Gabriel-Freitas-S/braco-robortico/impressao/pecas_fatiadas/README.md

# 🖨️ Arquivos Fatiados — Peças Individuais (Bambu Lab A1)

Contém os `.3mf` prontos para enviar diretamente à impressora Bambu Lab A1 —
29 peças (27 numeradas + H1 e H2).
Cada arquivo foi fatiado com:

- **Perfil:** `0.20mm Standard @BBL A1`
- **Bico:** 0.4 mm · **Material:** Bambu PLA Basic Preto (`#22262C`) · **Prato:** Textured PEI

> Os STLs originais (com numeração em relevo baixo) estão em `impressao/pecas/`.
>
> **Mudanças desta revisão:** a peça **26 (engrenagem) saiu do projeto**; a **04**
> usa a geometria de encaixe de 10 mm e a **12** é a Turret V7 Redonda (86 mm).
> As hastes `olhal_v4` e `curta` são as peças novas da garra.

## Tempos e Filamento por Peça

| Peça | Nome | Tempo | Filamento |
|---|---|---|---|
| 01 | Base_Chassi_Inferior | 42 min | 25.1 g |
| 02 | Braco_Principal_Esquerdo | 15 min | 2.8 g |
| 03 | Tirante_Paralelogramo_Longo | 16 min | 3.1 g |
| 04 | Tirante_Paralelogramo_Medio | 12 min | 2.4 g |
| 05 | Haste_Acionamento_Servo_Braco | 11 min | 1.9 g |
| 06 | Antebraco_Esquerdo | 11 min | 1.9 g |
| 07 | Braco_Principal_Direito | 12 min | 2.1 g |
| 08 | Antebraco_Direito | 11 min | 1.9 g |
| 09 | Torre_Suporte_Servo_Direita | 22 min | 6.5 g |
| 10 | Balancim_Triangular_Articulador | 14 min | 3.0 g |
| 11 | Torre_Suporte_Servo_Esquerda | 21 min | 5.8 g |
| 12 | Mesa_Giratoria_Turntable | 30 min | 15.2 g |
| 13 | Tirante_Superior_Garra | 11 min | 1.2 g |
| 14 | Separador_Espacador_Central_Base | 14 min | 2.8 g |
| 15 | Suporte_Cabeca_Garra | 11 min | 1.8 g |
| 16 | Berco_Servo_Rotacao_Base | 18 min | 5.6 g |
| 17 | Travessa_Reforco_Base_Frontal | 13 min | 2.3 g |
| 18 | Travessa_Reforco_Base_Traseira | 13 min | 2.1 g |
| 19 | Garra_Base_Suporte_Fixo | 13 min | 2.2 g |
| 20 | Garra_Dedo_Movel_Direito | 11 min | 1.3 g |
| 21 | Garra_Dedo_Movel_Esquerdo | 11 min | 1.3 g |
| 22 | Biela_Conexao_Horn_Direito | 12 min | 2.0 g |
| 23 | Biela_Conexao_Horn_Esquerdo | 12 min | 2.0 g |
| 24 | Suporte_Encaixe_Servo_Garra | 11 min | 1.4 g |
| 25 | Trava_Horn_Servo_Base | 10 min | 1.3 g |
| 27 | Guia_Articulacao_Garra | 9 min | 0.8 g |
| 28 | Biela_Articulacao_Curta | 8 min | 0.4 g |
| — | haste_articulacao_olhal_v4 | 9 min | 1.0 g |
| — | haste_articulacao_curta | 8 min | 0.6 g |
| **TOTAL** | **29 arquivos** | **7h 07min** | **101.7 g** |

*Estimativas geradas por Bambu Studio CLI oficial com perfil padrão 0.20 mm e Bambu PLA Basic Preto.*
