Gabriel-Freitas-S/braco-robortico/impressao/pratos/fatiados/README.md

# 🖨️ Pratos de Impressão Fatiados — Bambu Lab A1 (100% Filamento Preto)

Contém os 2 pratos `.3mf` prontos para enviar à Bambu Lab A1, configurados
exclusivamente para **Bambu PLA Basic Preto** (monocromático / slot único).
Fatiados com Bambu Studio 02.09.01.70 · `0.20mm Standard @BBL A1` · PLA ·
0.4 mm nozzle · Textured PEI Plate.

> Os pratos de projeto (sem gcode) ficam em `impressao/pratos/`.
>
> **Mudanças desta revisão:** peça **26 removida** (engrenagem), **04** com
> encaixe de 10 mm, **12** Turret V7 Redonda (86 mm) e as peças **H1/H2**
> incluídas no Prato 2.

---

## Prato 1 — Chassi, Base & Torres

**Arquivo:** `Prato_1_Chassi_Estrutura_Bambu_A1_sliced.3mf`

| Peça | Nome |
|---|---|
| 01 | Base_Chassi_Inferior |
| 09 | Torre_Suporte_Servo_Direita |
| 11 | Torre_Suporte_Servo_Esquerda |
| 12 | Mesa_Giratoria_Turntable (V7 Redonda) |
| 14 | Separador_Espacador_Central_Base |
| 16 | Berco_Servo_Rotacao_Base |
| 17 | Travessa_Reforco_Base_Frontal |
| 18 | Travessa_Reforco_Base_Traseira |
| 25 | Trava_Horn_Servo_Base |

- ⏱️ **Tempo de Impressão:** ~2h 10min
- 🧵 **Filamento:** 66.3 g Bambu PLA Basic Preto (#22262C)
- 📐 **Altura de Camada:** 0.20 mm Standard

---

## Prato 2 — Braço, Bielas & Garra

**Arquivo:** `Prato_2_Mecanica_Garra_Bambu_A1_sliced.3mf`

| Peça | Nome |
|---|---|
| 02 | Braco_Principal_Esquerdo |
| 03 | Tirante_Paralelogramo_Longo |
| 04 | Tirante_Paralelogramo_Medio (encaixe 10 mm) |
| 05 | Haste_Acionamento_Servo_Braco |
| 06 | Antebraco_Esquerdo |
| 07 | Braco_Principal_Direito |
| 08 | Antebraco_Direito |
| 10 | Balancim_Triangular_Articulador |
| 13 | Tirante_Superior_Garra |
| 15 | Suporte_Cabeca_Garra |
| 19 | Garra_Base_Suporte_Fixo |
| 20 | Garra_Dedo_Movel_Direito |
| 21 | Garra_Dedo_Movel_Esquerdo |
| 22 | Biela_Conexao_Horn_Direito |
| 23 | Biela_Conexao_Horn_Esquerdo |
| 24 | Suporte_Encaixe_Servo_Garra |
| 27 | Guia_Articulacao_Garra |
| 28 | Biela_Articulacao_Curta |
| — | haste_articulacao_olhal_v4 |
| — | haste_articulacao_curta |

- ⏱️ **Tempo de Impressão:** ~2h 03min
- 🧵 **Filamento:** 36.0 g Bambu PLA Basic Preto (#22262C)
- 📐 **Altura de Camada:** 0.20 mm Standard

---

## Resumo Geral

| Prato | Peças | Tempo Estimado | Filamento | Status |
|---|---|---|---|---|
| **Prato 1 (Chassi/Base)** | 9 | 2h 10min | 66.3 g | ✅ Pronto |
| **Prato 2 (Braço/Garra)** | 20 | 2h 03min | 36.0 g | ✅ Pronto |
| **TOTAL** | **29** | **~4h 13min** | **~102.3 g PLA Preto** | 1 carretel de 1 kg basta |

> 💡 **Nota:** com o projeto 100% em filamento preto não há troca de filamento
> nem torre de purga.
>
> ⚠️ **Calibração:** habilite a *Flow Dynamics Calibration* antes do Prato 2
> para as tolerâncias dos dedos 20/21 e da guia 27.
