Gabriel-Freitas-S/braco-robortico/app/README.md

# RoboControl — controle e gravação do braço 4-DOF

App desktop (Rust + egui) que conversa com o firmware pela USB em 115200 baud.
O firmware continua dono do movimento: aqui só **propomos alvos**. A rampa, os
limites mecânicos e o hold ficam na placa, então um comando perdido no USB não
vira tranco.

## Requisitos

| | |
|---|---|
| **Todos** | Rust stable + `cargo`; Arduino Uno + cabo USB |
| **Linux** | usuário no grupo `dialout` (Arch: `uucp`) + libs de build |
| **Windows** | Rust MSVC + *Desktop development with C++*; driver CH340 em clones |
| **macOS** | Xcode Command Line Tools |

O `install.sh` é só Linux; nos outros sistemas use `cargo run --release`.

## Rodar

### Linux

```bash
cd app && ./install.sh   # opcional: instala no menu
# ou: cargo run --release
```

Instala sem root: binário em `~/.local/bin/robocontrol`, ícone e entrada
**RoboControl** no menu de aplicativos. Movimentos em
`~/.local/share/robocontrol/movimentos/` (ou `$XDG_DATA_HOME/...`).

### macOS

```bash
cd app && cargo run --release
```

Movimentos em `~/.local/share/robocontrol/movimentos/`.

### Windows (PowerShell)

```powershell
cd app
cargo run --release
# ou: cargo build --release; .\target\release\robocontrol.exe
```

Movimentos em `%APPDATA%\robocontrol\movimentos`.

Depois: escolher a porta (Linux `/dev/ttyACM0`; macOS `/dev/cu.usbmodem*`;
Windows `COM3`) → **Conectar** → **Assumir controle (PC)**.

A tela mostra **dois pads de toque**, no mesmo layout da bancada:

| Pad | Eixo X | Eixo Y |
|---|---|---|
| Esquerdo | Base | Cotovelo |
| Direito | Garra | Ombro |

Arrastar move como alavanca; **soltar o dedo centraliza = segurar a posição**.

## Modo híbrido (a regra de segurança)

| Situação | O que acontece |
|---|---|
| Joystick na mão | o firmware ignora o PC |
| **Assumir controle (PC)** | firmware adota os alvos partindo do ângulo atual |
| **Joystick com o PC no controle** | fica **travado**: mexer a alavanca não interfere (v1.3.3) |
| **Devolver ao joystick** / STOP | única forma de pegar o controle de volta na mão |
| 500 ms sem alvos (app travou, cabo caiu) | segura a posição atual e devolve ao joystick |
| **STOP** | `#H`: segura as juntas agora |
| **Travar garra** | `#L1`: mantém pressão contínua no objeto e bloqueia abertura |
| **Liberar garra** | `#L0`: a garra volta a abrir pelo pad |

A trava é a mesma do botão físico D4 — um só estado (`garraTravada`) no firmware,
então o botão da bancada e o botão do app nunca discordam. Com a trava ativa a
garra **só aperta**: nem o pad, nem o replay (`#P`) conseguem abrir.

## Gravação

- **Gravar** captura a pose a 20 Hz — inclusive quando você está movendo no
  joystick (é "ensinar fazendo").
- **Parar e salvar** grava em `~/.local/share/robocontrol/movimentos/<nome>.json` (Windows: `%APPDATA%\robocontrol\movimentos`).
- **▶** carrega um movimento; **✕** exclui (com confirmação na própria linha); **Reproduzir** manda os alvos interpolados.
  Tocar o joystick cancela o replay (o firmware sai do modo PC).

## Protocolo (firmware v1.3+)

```
#P<b>;<o>;<c>;<g>   alvos em graus (replay / ajuste fino)
#V<lx>;<ly>;<rx>;<ry>  sticks virtuais -100..100 (20 Hz; reenviar é o heartbeat)
#M                  assume o controle
#J                  devolve ao joystick
#H                  segura agora
#L0 / #L1           libera / trava a pressão da garra
#S                  status  →  S<b>;<o>;<c>;<g>;<modo>;<trava>
#B                  diagnóstico → B<versão>;boots=N;limb=min;max;limo=...;limc=...;limg=...
```

Testar sem o app:

```bash
# Linux
stty -F /dev/ttyACM0 115200 raw -echo
printf '#B\n' > /dev/ttyACM0 && cat /dev/ttyACM0
```

## Diagnóstico de alimentação

O app mostra `boots=N` (contador de resets em `.noinit`). **Se esse número subir
enquanto o braço se move, a placa reiniciou** — é a alimentação, não o servo.
O aviso aparece em vermelho na barra superior.

## Estrutura

- `src/protocol.rs` — codificação/decodificação das linhas (testado)
- `src/link.rs` — porta serial: leitura em thread, escrita síncrona
- `src/motion.rs` — gravação, interpolação do replay, JSON (testado)
- `src/main.rs` — UI egui (pads de toque, gravação, replay)

## Documentação

O código usa rustdoc (`//!` nos módulos, `///` nos itens). A versão navegável
fica em [`docs/rust/`](../docs/rust/robocontrol/index.html) e é publicada em
<https://gabriel-freitas-s.github.io/braco-robortico/rust/robocontrol/index.html>.
Para regenerar depois de mudar o código:

```bash
cargo doc --no-deps --document-private-items
rsync -a --delete --exclude='.lock' --exclude='/index.html' target/doc/ ../docs/rust/
```

`--document-private-items` é obrigatório: o crate é binário, então sem ele o
HTML sai quase vazio. O `--exclude='/index.html'` preserva o redirecionamento
de `docs/rust/` para `robocontrol/`.

## Sentido dos eixos

`#V` positivo em X do pad esquerdo **diminui** o ângulo da base; Y para cima do
pad esquerdo **aumenta** o cotovelo; X do pad direito **abre** a garra; Y para
cima **aumenta** o ombro. Se algum ficar invertido na mão, é só trocar o sinal
na montagem de `cmd_sticks` em `tick()`.
