Gabriel-Freitas-S/braco-robortico/.opencode/command/doctor.md

---
description: Verifica a configuração local de fabricação e relata dependências ausentes.
agent: build
---

No diretório raiz do projeto, execute `python .agents/skills/bambu-studio-ai/scripts/doctor.py`. Relate o que está ausente ou precisa de configuração, incluindo Bambu Studio e configuração de impressoras.

Contexto: $ARGUMENTS
