Gabriel-Freitas-S/braco-robortico/bambu-output/braco_montado_numerado_preview.png

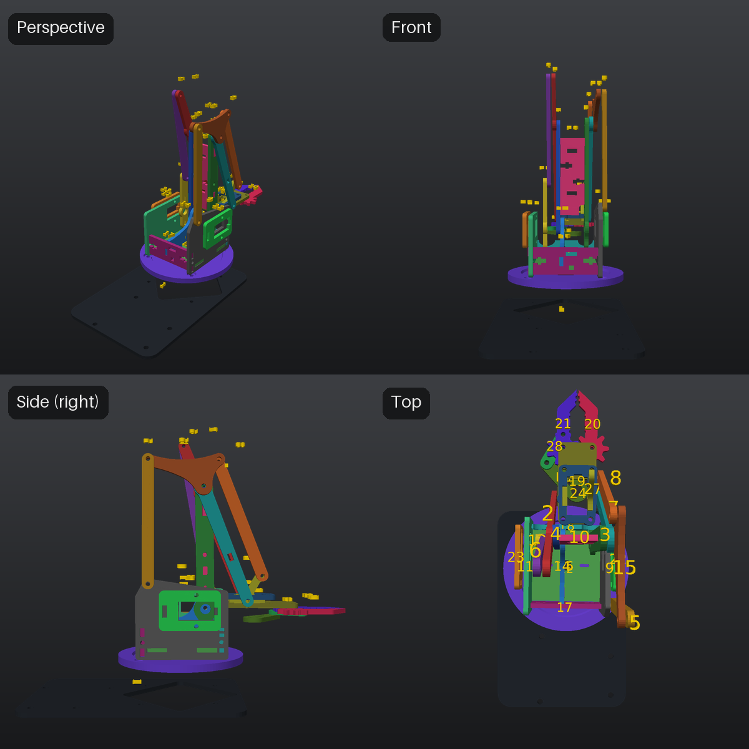
bambu-output/braco_montado_numerado_preview.png
