Gabriel-Freitas-S/braco-robortico/cad-output/01_Base_Chassi_Inferior_preview.png

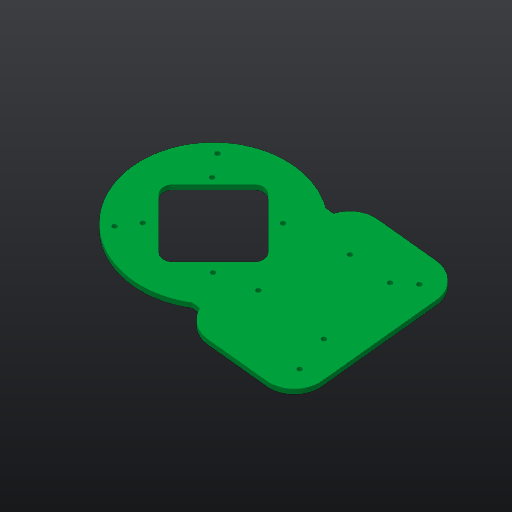
cad-output/01_Base_Chassi_Inferior_preview.png
