Gabriel-Freitas-S/braco-robortico/cad-output/04_Tirante_Paralelogramo_Medio_preview.png

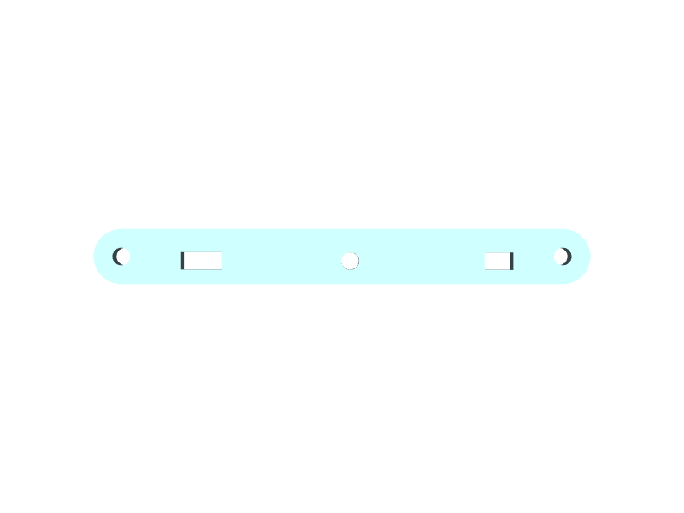
cad-output/04_Tirante_Paralelogramo_Medio_preview.png
