Gabriel-Freitas-S/braco-robortico/cad-output/hastes_articulacao_iso.png

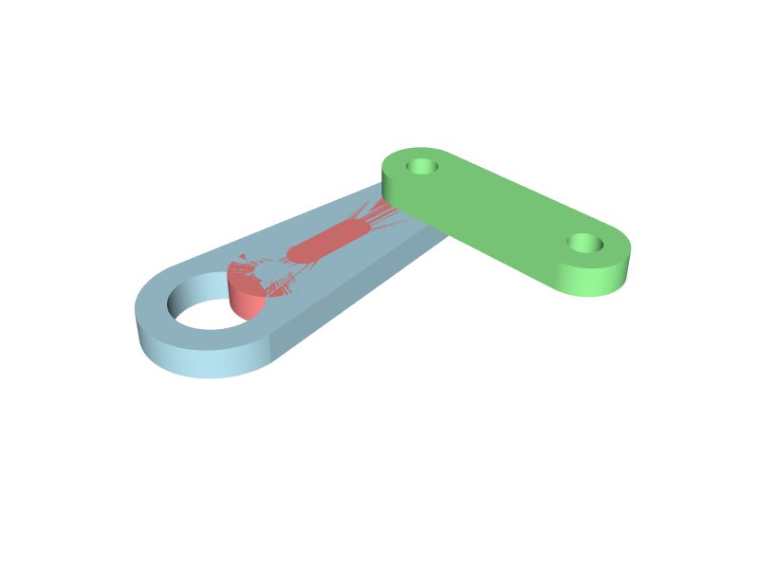
cad-output/hastes_articulacao_iso.png
