Gabriel-Freitas-S/braco-robortico/docs/assets/renders/base_01_original_mdf_3d.png

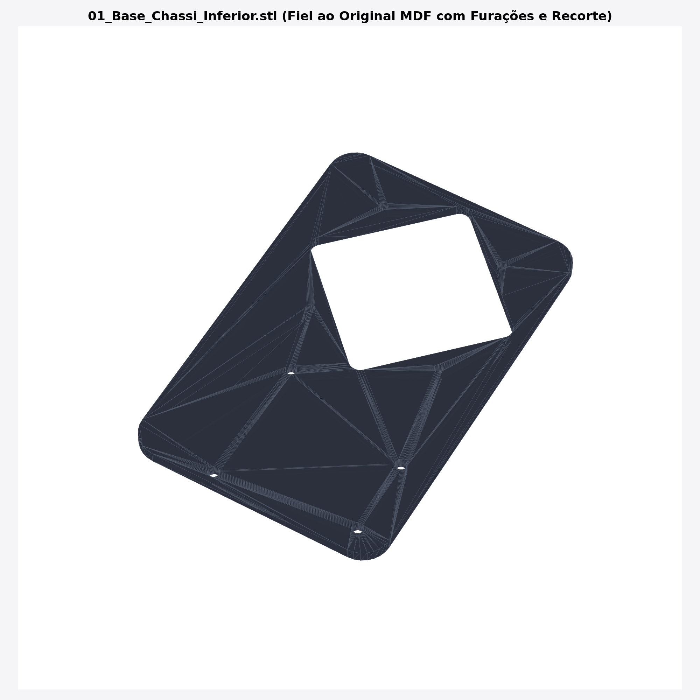
docs/assets/renders/base_01_original_mdf_3d.png
