Gabriel-Freitas-S/braco-robortico/docs/assets/renders/base_01_rectangular_preview.png

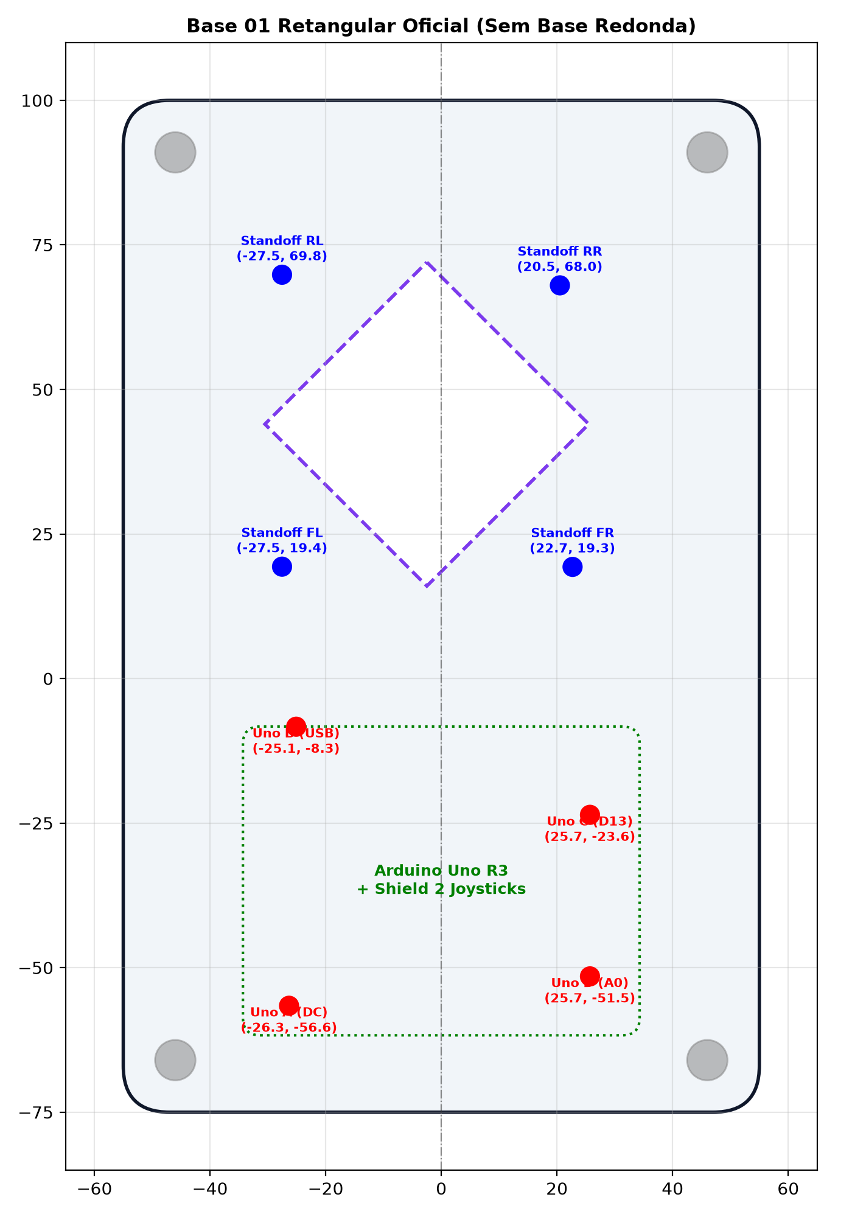
docs/assets/renders/base_01_rectangular_preview.png
