Gabriel-Freitas-S/braco-robortico/docs/assets/renders/base_01_symmetric_preview.png

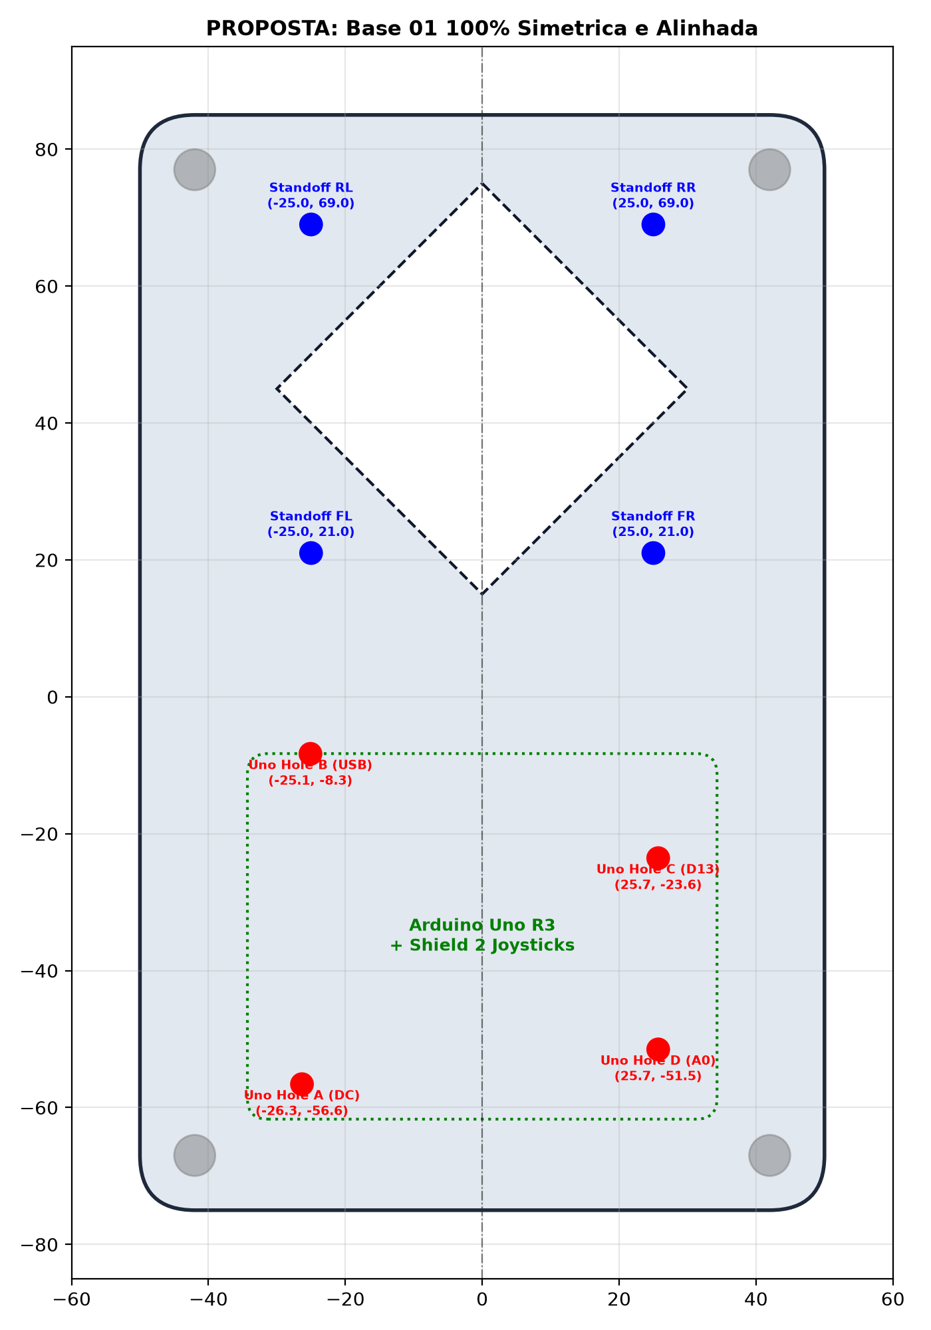
docs/assets/renders/base_01_symmetric_preview.png
