Gabriel-Freitas-S/braco-robortico/docs/assets/renders/base_plate_comparison.png

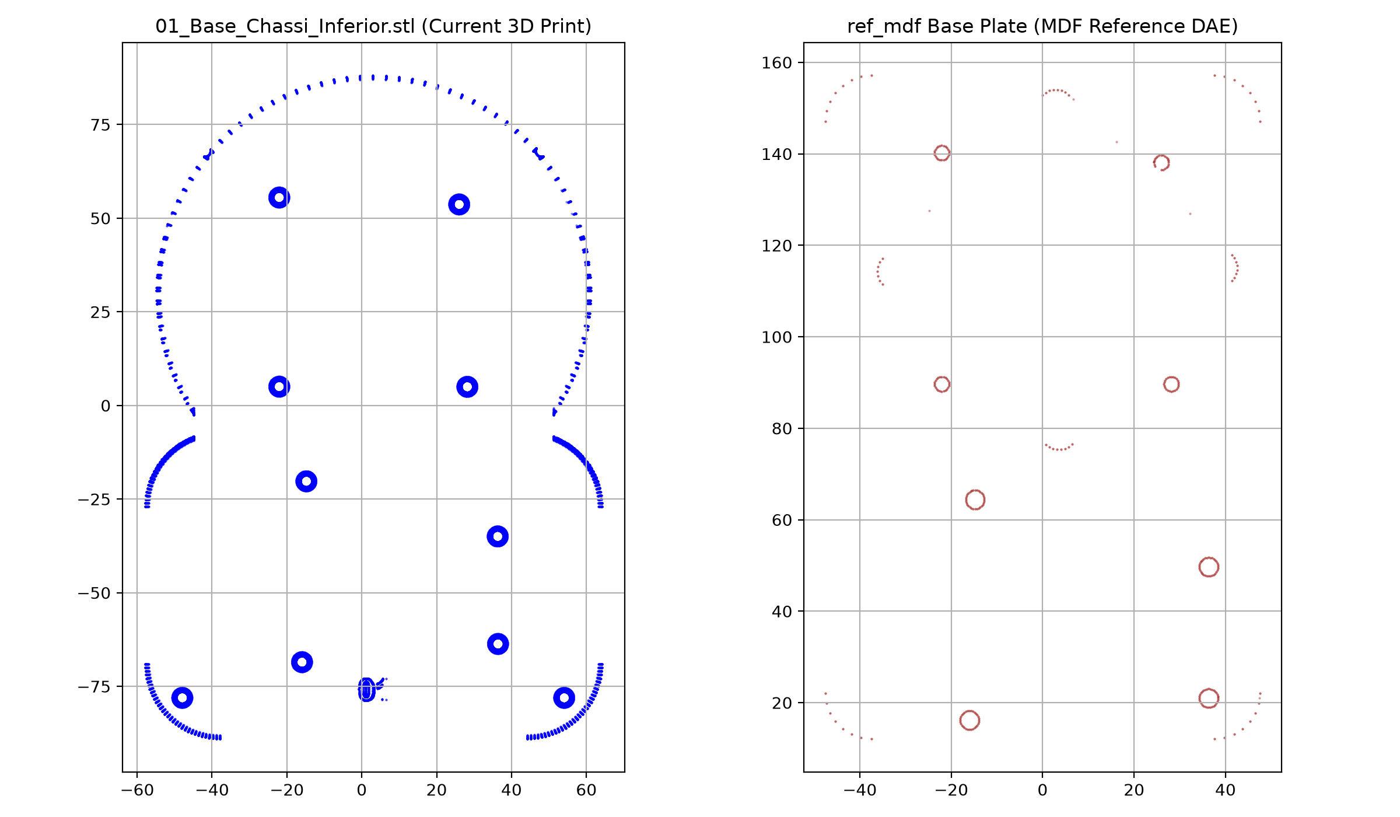
docs/assets/renders/base_plate_comparison.png
