Gabriel-Freitas-S/braco-robortico/docs/assets/renders/base_servo_underside_check.png

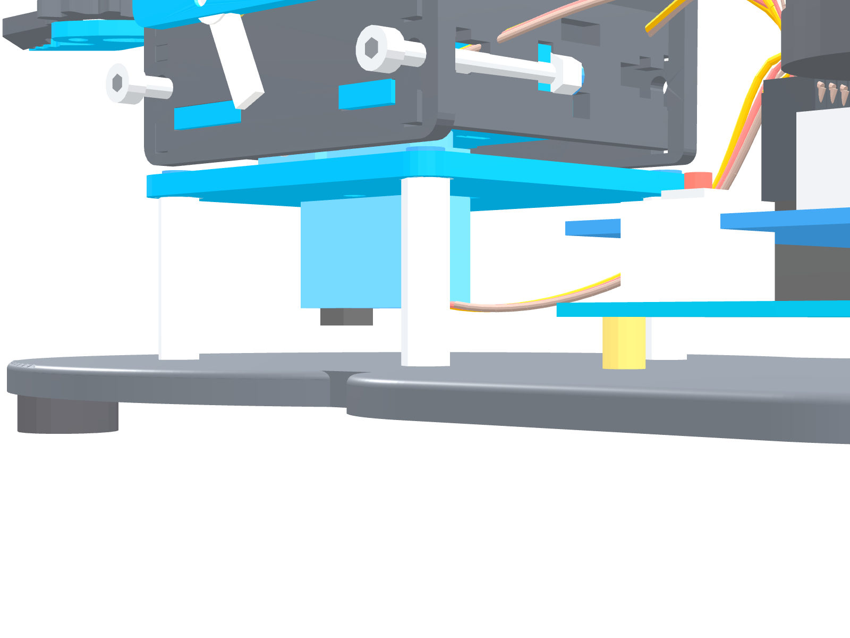
docs/assets/renders/base_servo_underside_check.png
