Gabriel-Freitas-S/braco-robortico/docs/assets/renders/braco_capa_lateral_dinamica.png

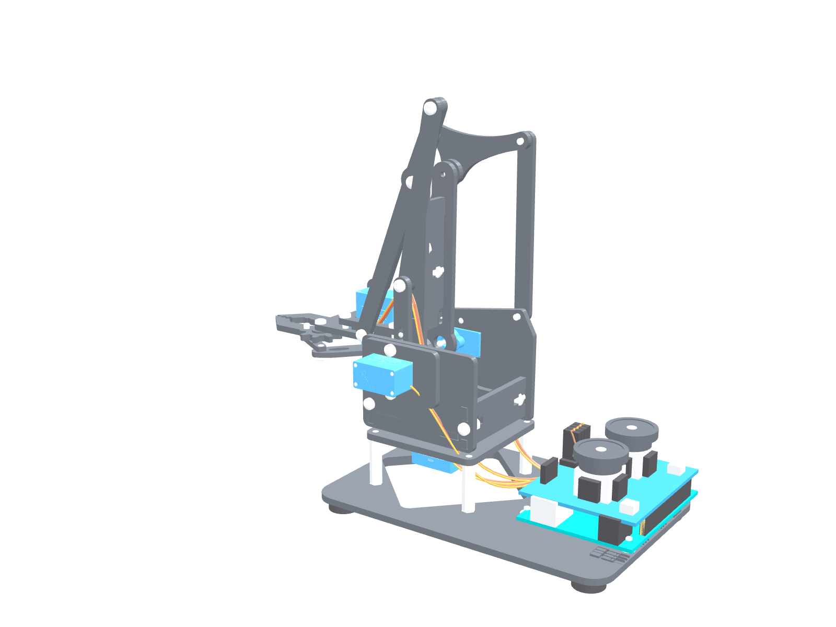
docs/assets/renders/braco_capa_lateral_dinamica.png
