Gabriel-Freitas-S/braco-robortico/docs/assets/renders/braco_colorido_iso.png

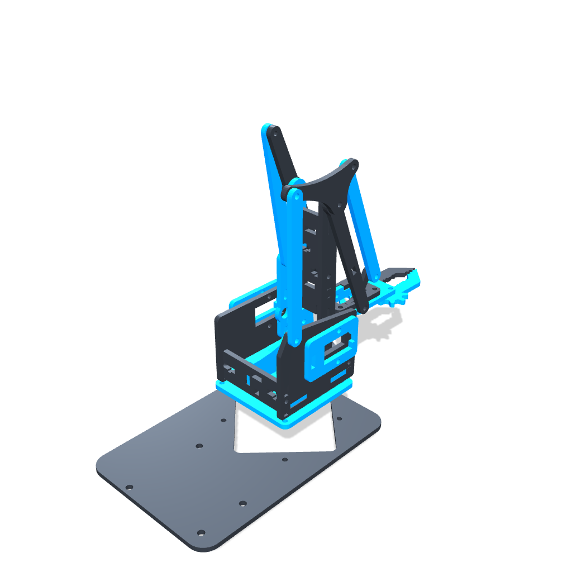
docs/assets/renders/braco_colorido_iso.png
