Gabriel-Freitas-S/braco-robortico/docs/assets/renders/braco_original_front.png

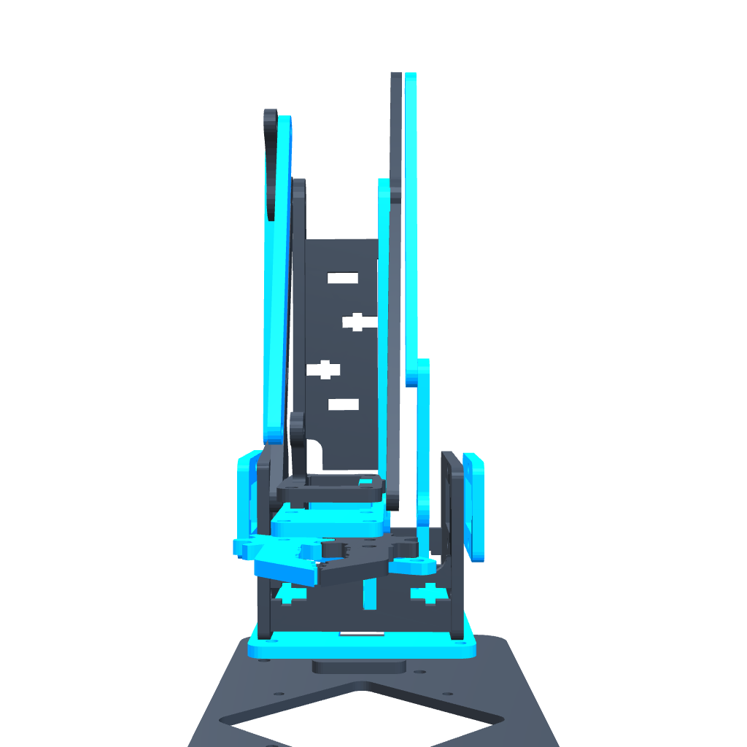
docs/assets/renders/braco_original_front.png
