Gabriel-Freitas-S/braco-robortico/docs/assets/renders/braco_original_iso.png

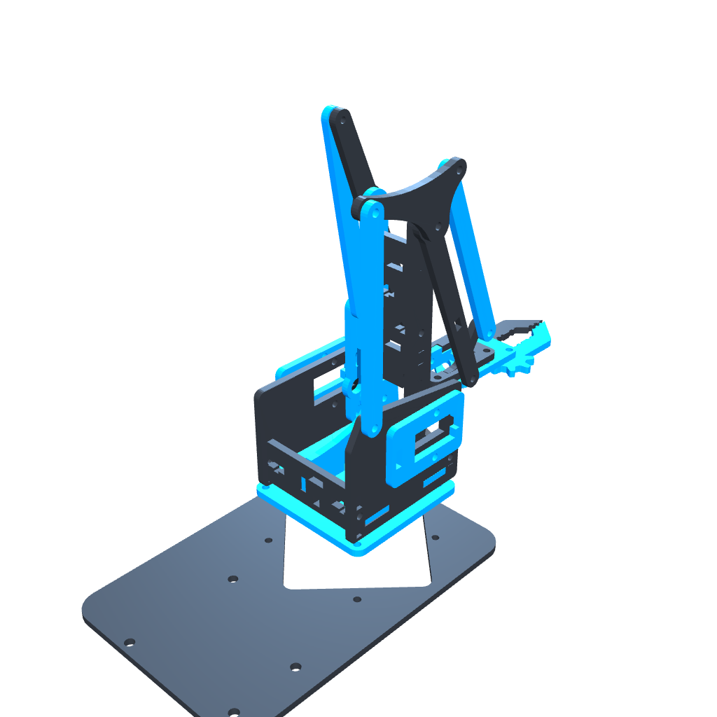
docs/assets/renders/braco_original_iso.png
