Gabriel-Freitas-S/braco-robortico/docs/assets/renders/braco_original_side.png

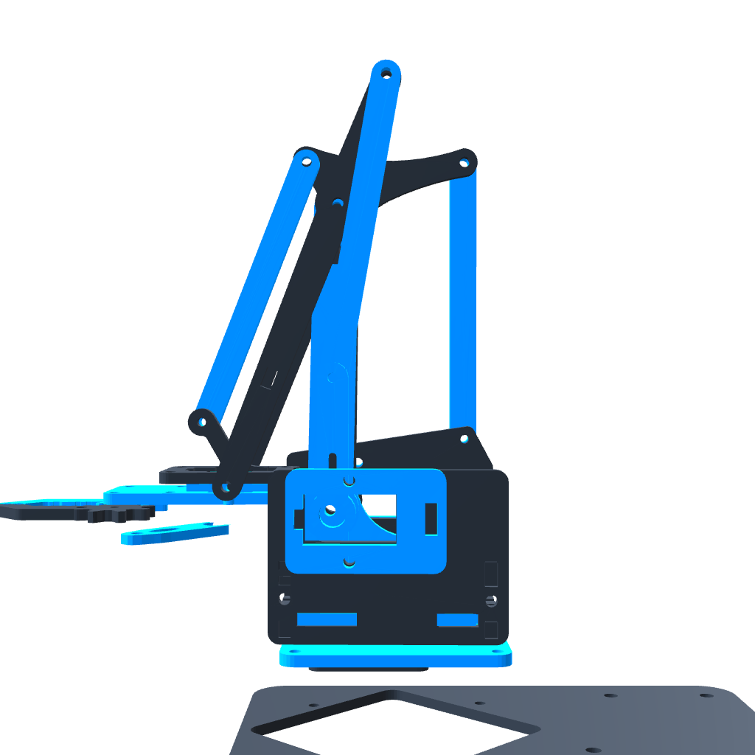
docs/assets/renders/braco_original_side.png
