Gabriel-Freitas-S/braco-robortico/docs/assets/renders/braco_original_top.png

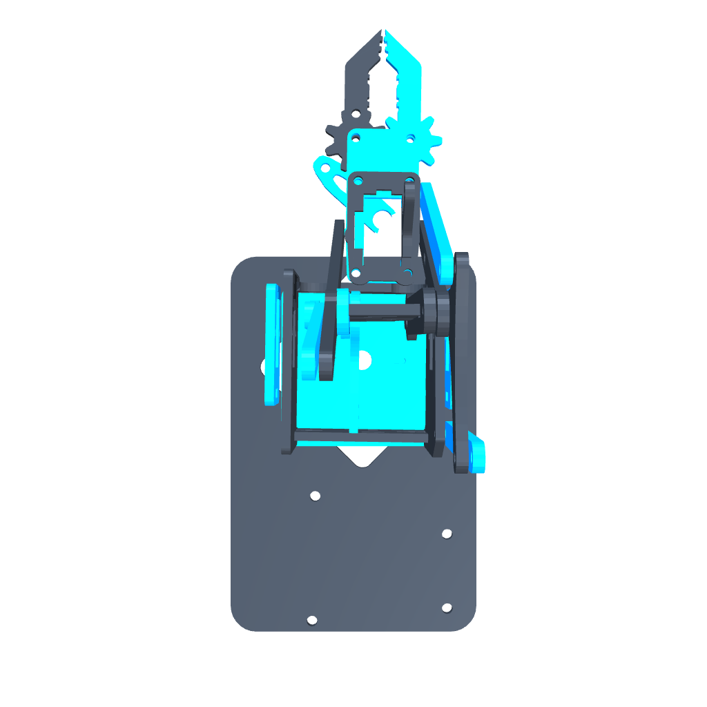
docs/assets/renders/braco_original_top.png
