Gabriel-Freitas-S/braco-robortico/docs/assets/renders/first_commit_base.png

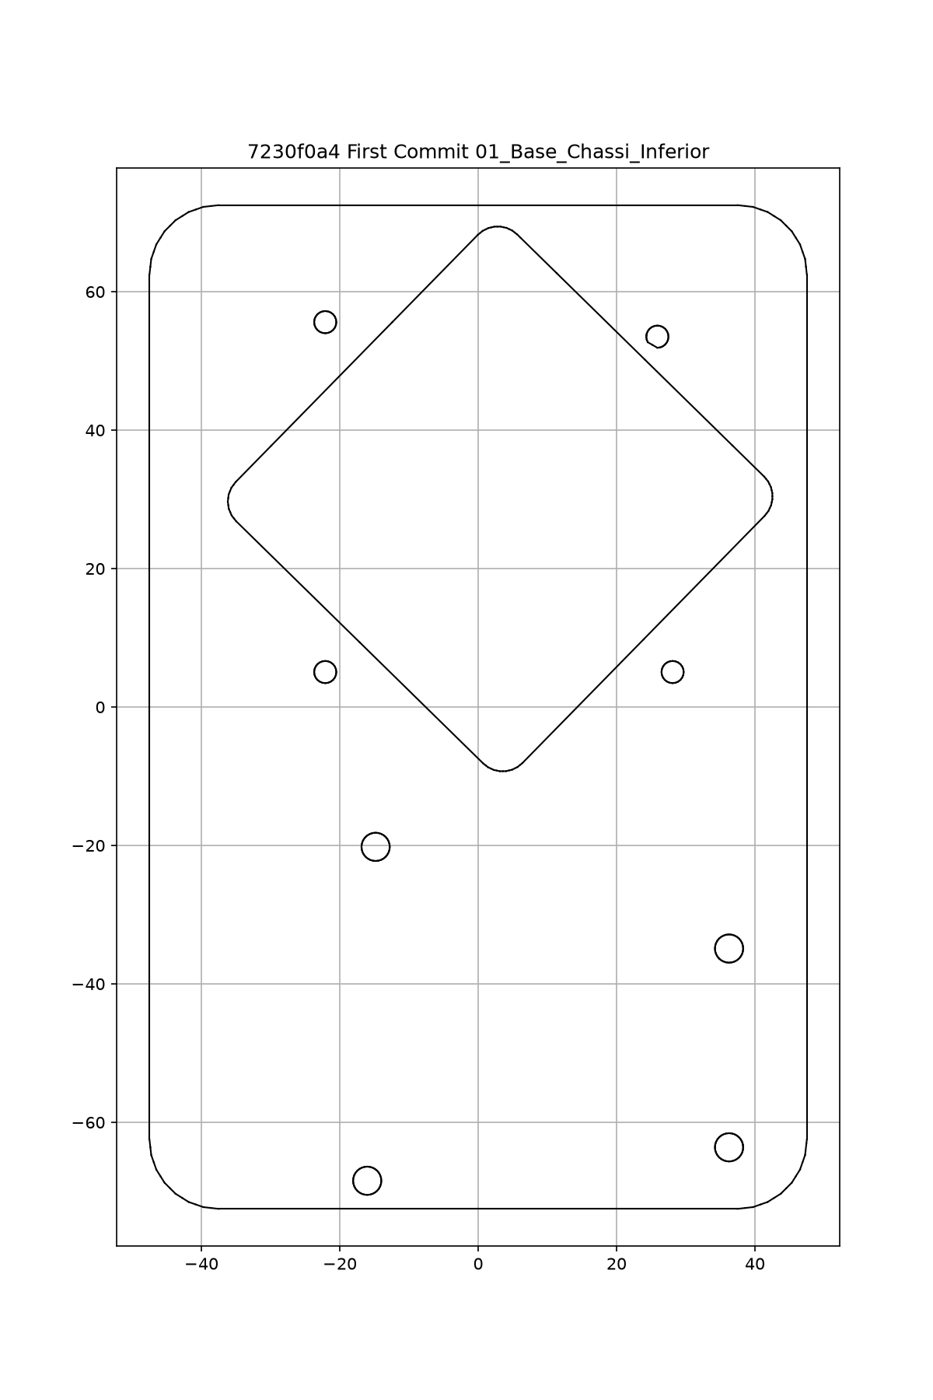
docs/assets/renders/first_commit_base.png
