Gabriel-Freitas-S/braco-robortico/docs/assets/renders/joystick_shield_arm_iso.png

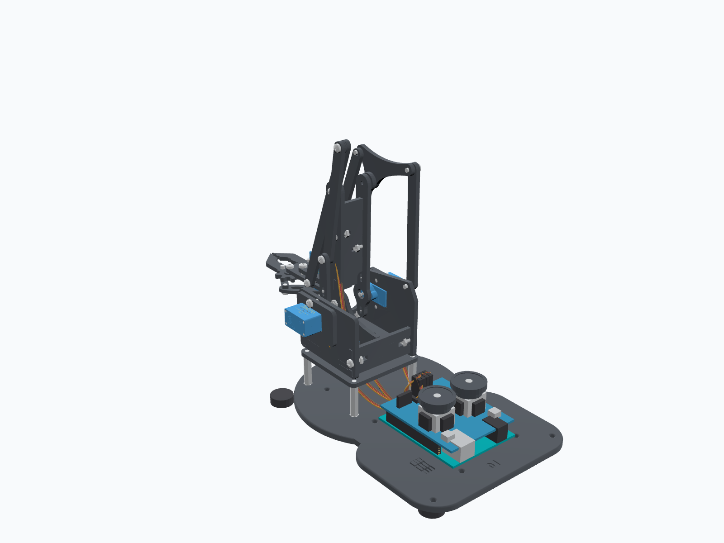
docs/assets/renders/joystick_shield_arm_iso.png
