Gabriel-Freitas-S/braco-robortico/docs/assets/renders/joystick_shield_zoom.png

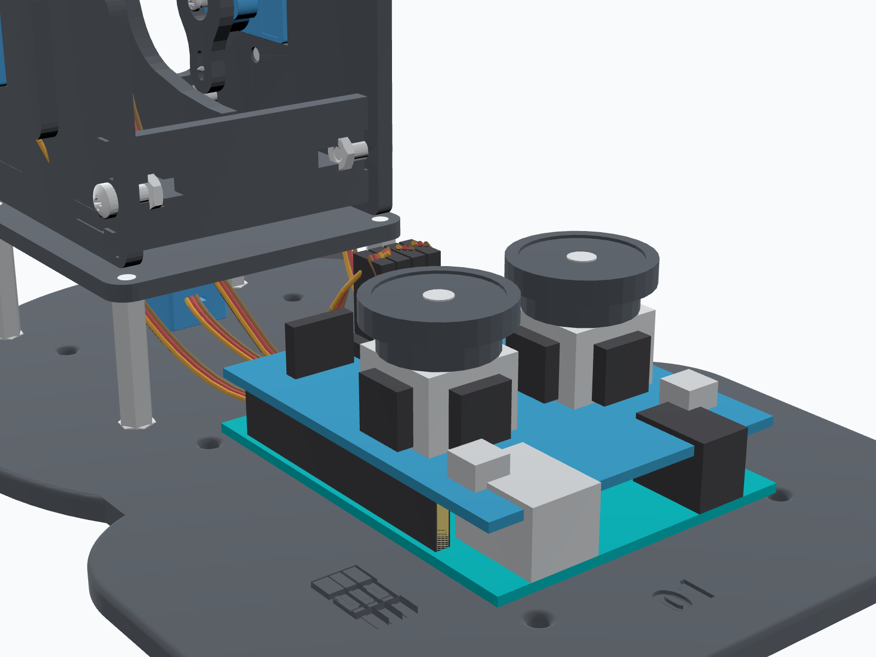
docs/assets/renders/joystick_shield_zoom.png
