Gabriel-Freitas-S/braco-robortico/docs/assets/renders/mdf_base_profile_detailed.png

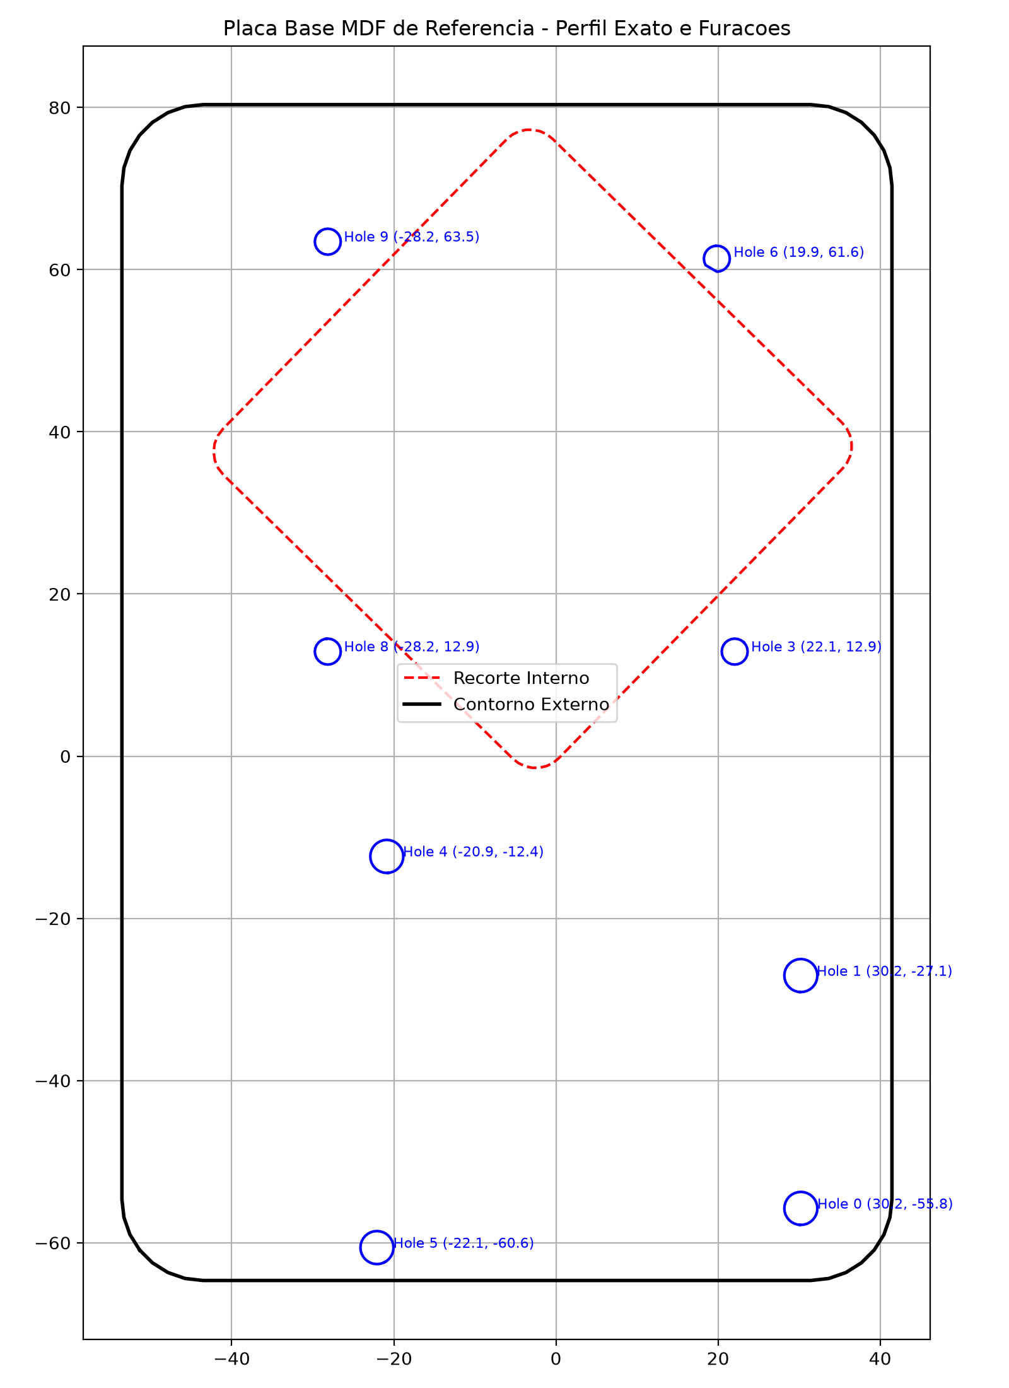
docs/assets/renders/mdf_base_profile_detailed.png
