Gabriel-Freitas-S/braco-robortico/docs/assets/renders/mesa_bambu_knolled.png

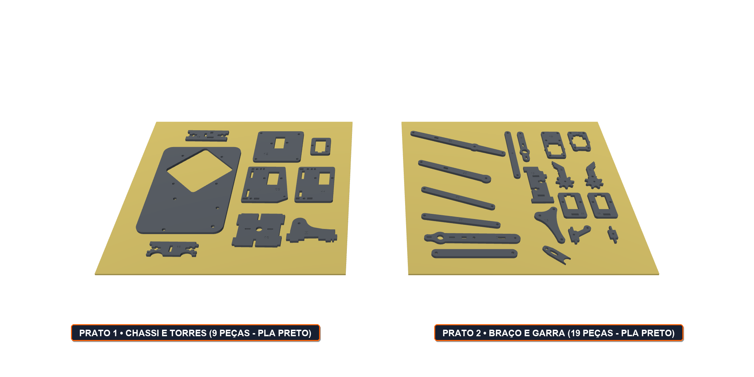
docs/assets/renders/mesa_bambu_knolled.png
