Gabriel-Freitas-S/braco-robortico/docs/assets/renders/mesa_bambu_knolled_raw.png

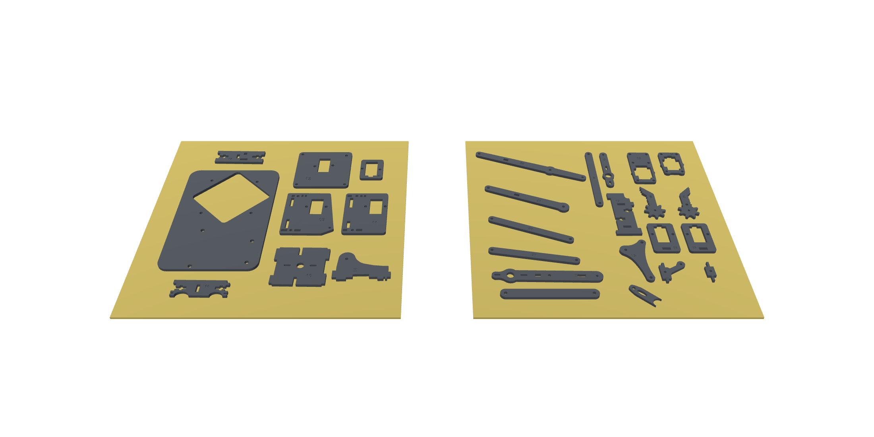
docs/assets/renders/mesa_bambu_knolled_raw.png
