Gabriel-Freitas-S/braco-robortico/docs/assets/renders/mesa_prato1_bambu.png

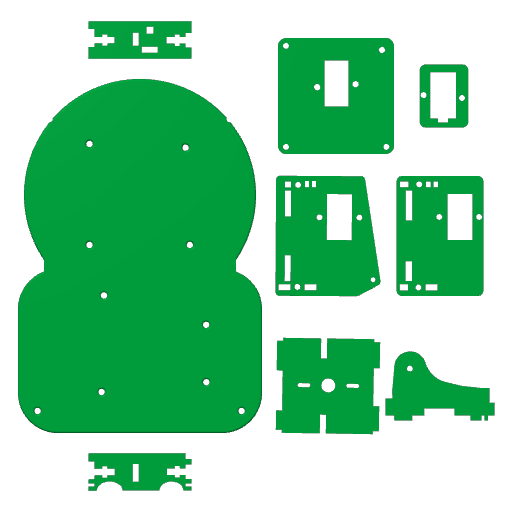
docs/assets/renders/mesa_prato1_bambu.png
