Gabriel-Freitas-S/braco-robortico/docs/assets/renders/mesa_prato2_bambu.png

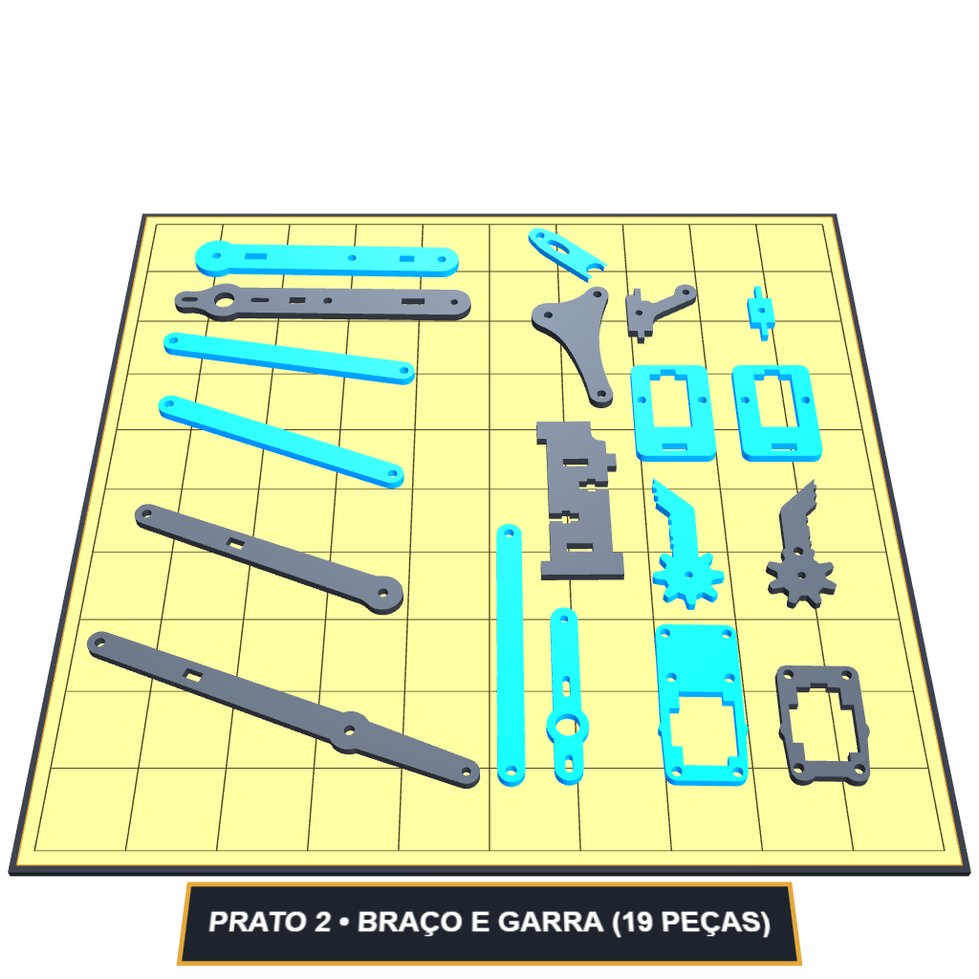
docs/assets/renders/mesa_prato2_bambu.png
