Gabriel-Freitas-S/braco-robortico/docs/assets/renders/new_base_plate_2d_check.png

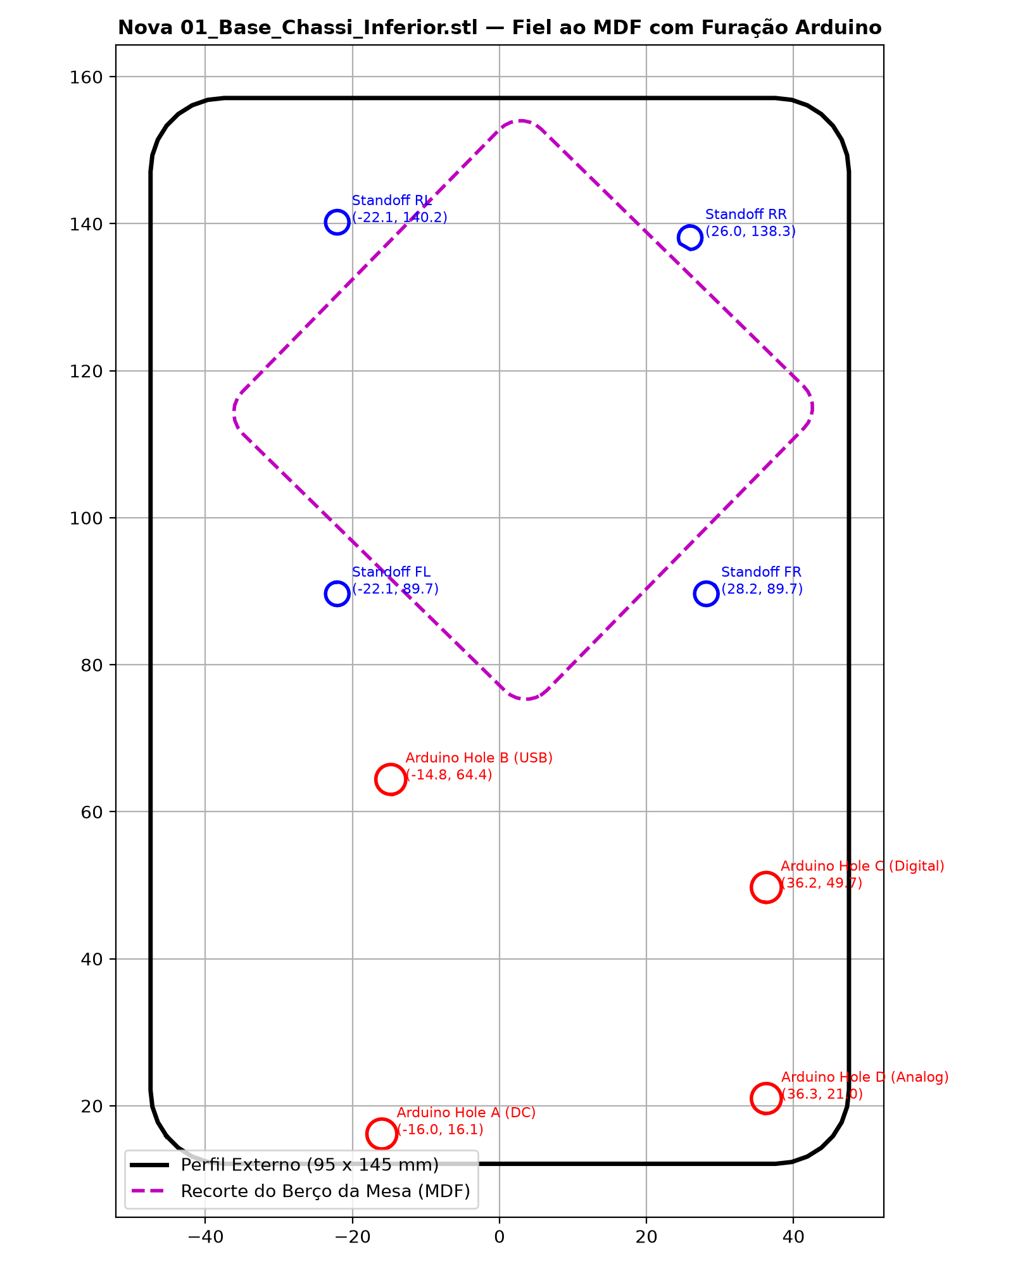
docs/assets/renders/new_base_plate_2d_check.png
