Gabriel-Freitas-S/braco-robortico/docs/assets/renders/shield_dupont_connections_zoom.png

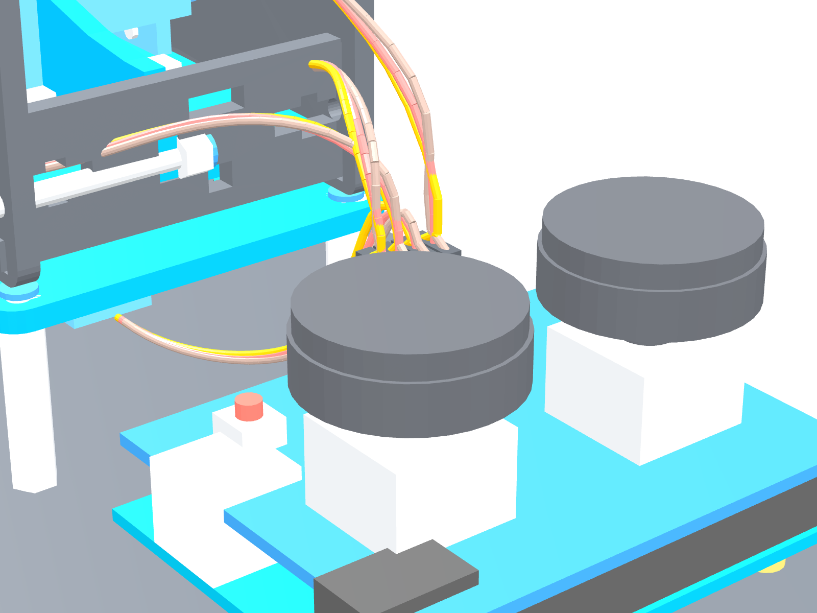
docs/assets/renders/shield_dupont_connections_zoom.png
