Gabriel-Freitas-S/braco-robortico/docs/assets/renders/subconjunto_1_base.png

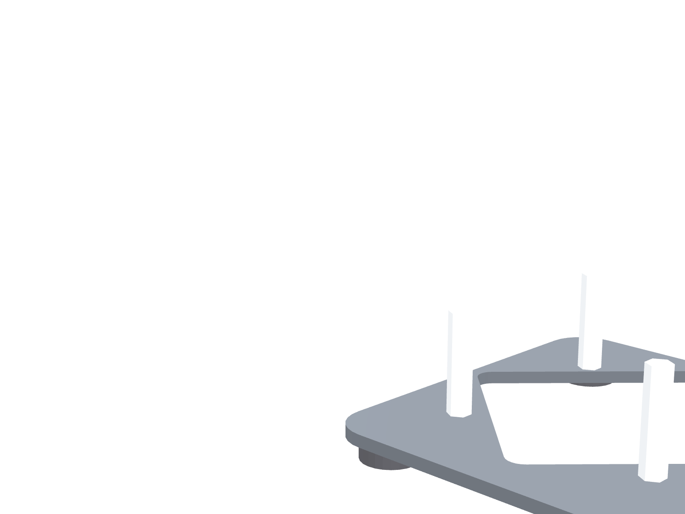
docs/assets/renders/subconjunto_1_base.png
