Gabriel-Freitas-S/braco-robortico/docs/assets/site/curta.png

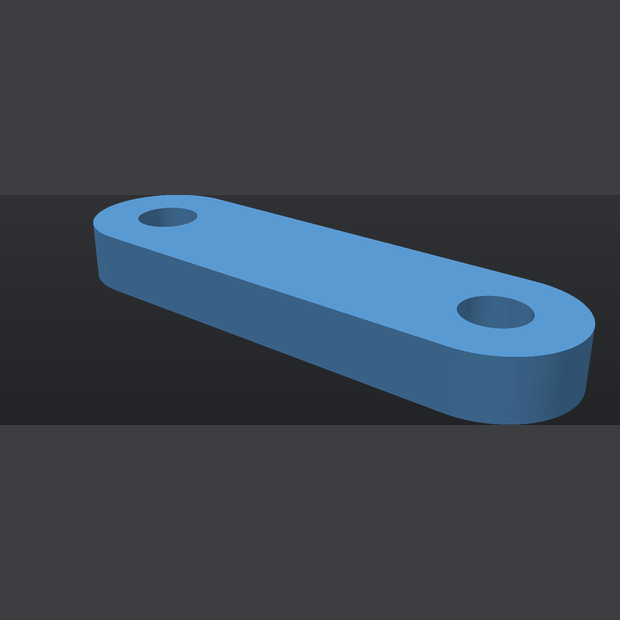
docs/assets/site/curta.png
