Gabriel-Freitas-S/braco-robortico/docs/assets/site/peca04.png

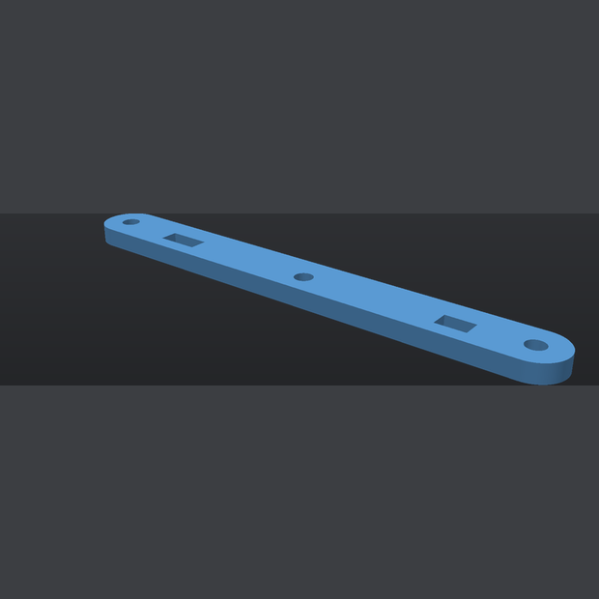
docs/assets/site/peca04.png
