Gabriel-Freitas-S/braco-robortico/docs/assets/site/peca12.png

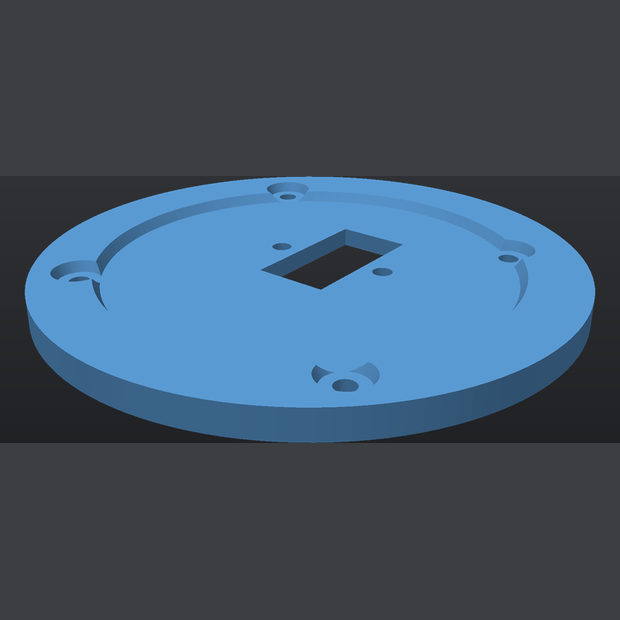
docs/assets/site/peca12.png
