Gabriel-Freitas-S/braco-robortico/docs/assets/site/prato1.png

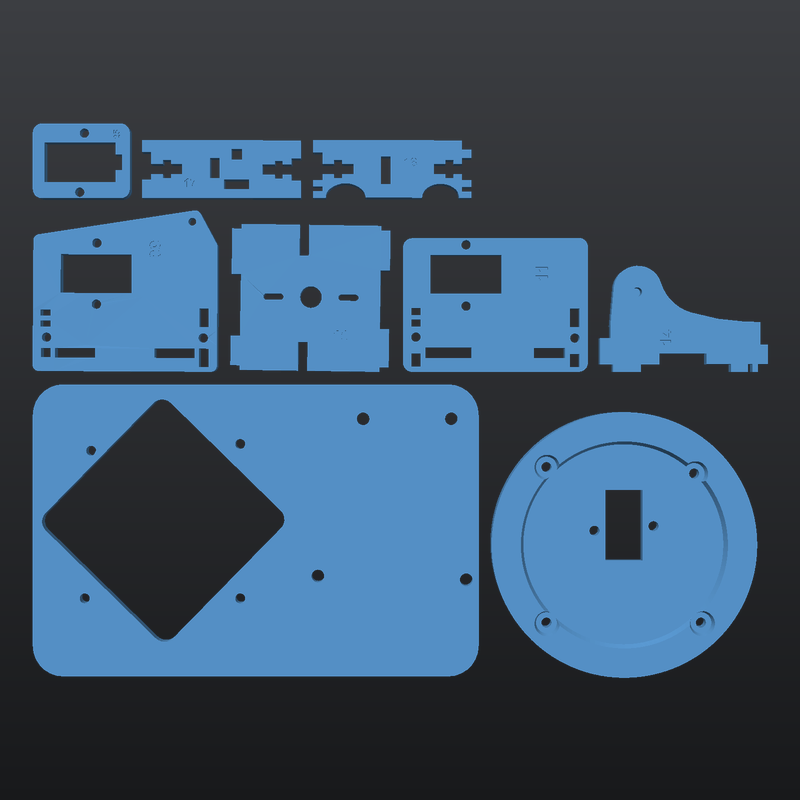
docs/assets/site/prato1.png
