Gabriel-Freitas-S/braco-robortico/docs/assets/site/prato2.png

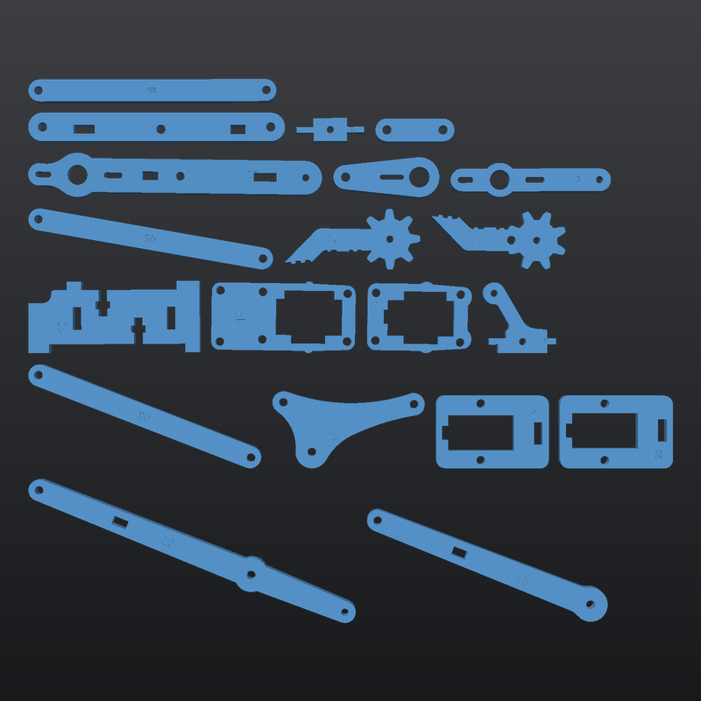
docs/assets/site/prato2.png
