Gabriel-Freitas-S/braco-robortico/ref/mdf/referencia_mecanismo.png

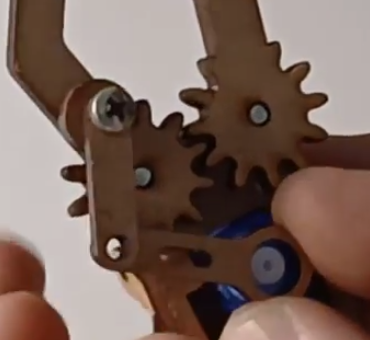
ref/mdf/referencia_mecanismo.png
