Gabriel-Freitas-S/braco-robortico/ref/mdf/textures/Arduino UNO Rev.3 (CH340) (2).png.003.png

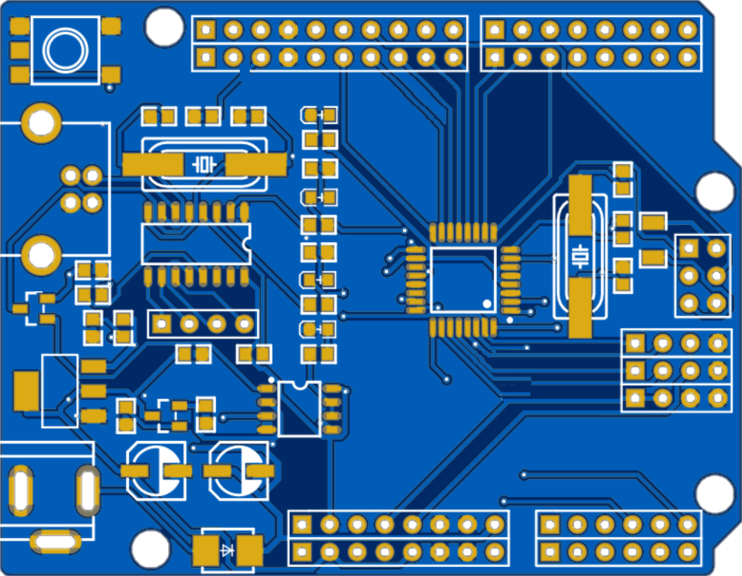
ref/mdf/textures/Arduino UNO Rev.3 (CH340) (2).png.003.png
