Gabriel-Freitas-S/braco-robortico/ref/mdf/textures/Arduino UNO Rev.3 (CH340).png.001.png

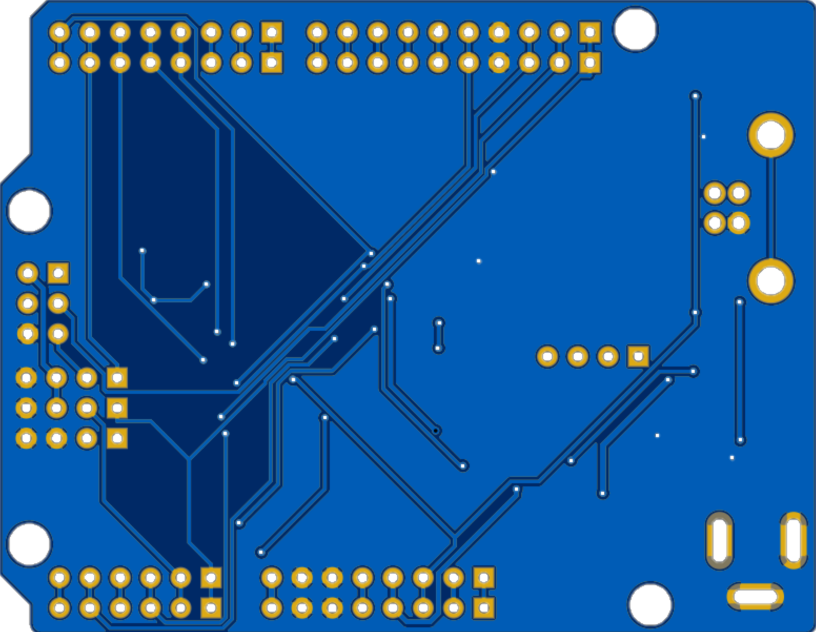
ref/mdf/textures/Arduino UNO Rev.3 (CH340).png.001.png
