Gabriel-Freitas-S/braco-robortico/ref/mdf/textures/mdf cruz.png.001.png

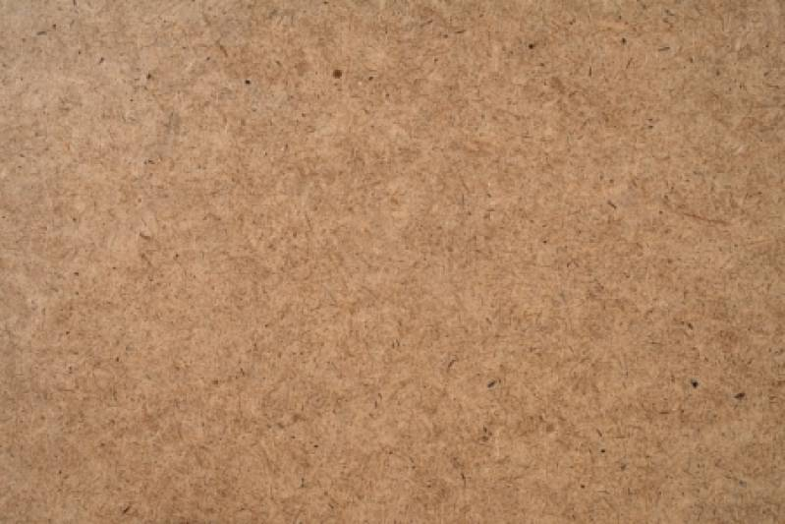
ref/mdf/textures/mdf cruz.png.001.png
