Gabriel-Freitas-S/braco-robortico/cad-output/04_Tirante_Paralelogramo_Medio.step

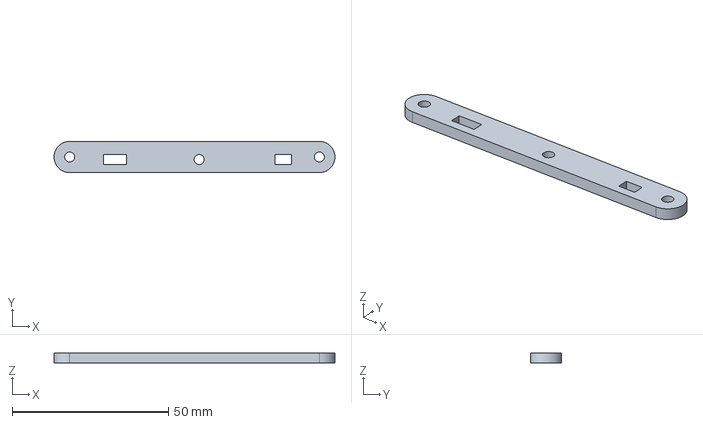
[picture p40: CAD file, 2026-11-07]
cad-output/04_Tirante_Paralelogramo_Medio.step
90.0 x 10.0 x 3.20 mm
