Gabriel-Freitas-S/braco-robortico/impressao/pecas/12_Mesa_Giratoria_Turntable.stl

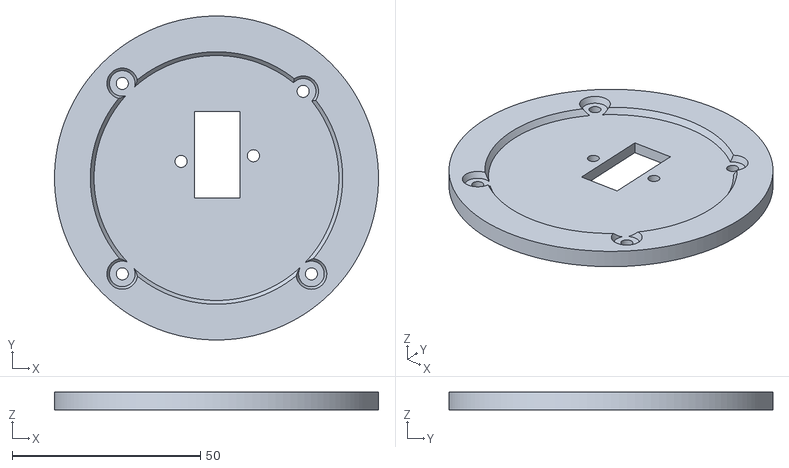
[picture p41: CAD file, 2026-11-13]
impressao/pecas/12_Mesa_Giratoria_Turntable.stl
86.0 x 86.0 x 4.70
