Gabriel-Freitas-S/braco-robortico/impressao/pratos/fatiados/Prato_2_Mecanica_Garra_Bambu_A1_sliced.3mf

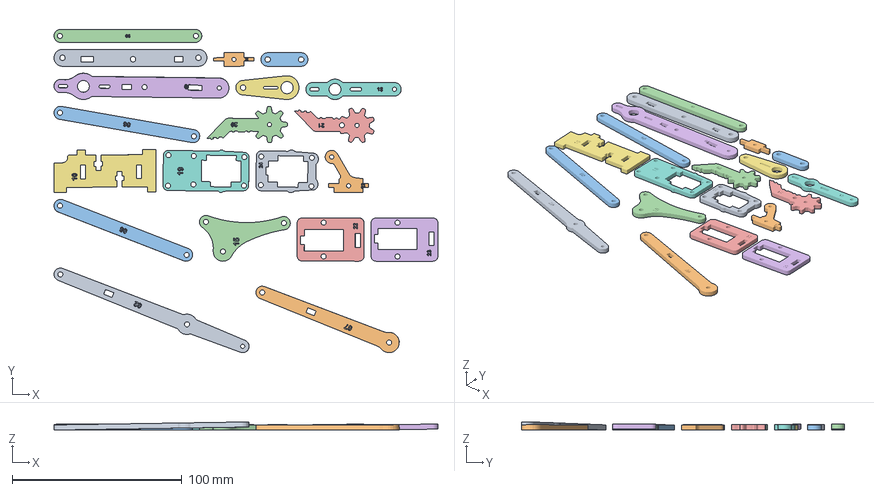
[picture p42: CAD file, 2026-11-13]
impressao/pratos/fatiados/Prato_2_Mecanica_Garra_Bambu_A1_sliced.3mf
226.0 x 190.2 x 4.79 mm
02_Braco_Principal_Esquerdo
07_Braco_Principal_Direito
08_Antebraco_Direito
15_Suporte_Cabeca_Garra
22_Biela_Conexao_Horn_Direito
23_Biela_Conexao_Horn_Esquerdo
10_Balancim_Triangular_Articulador
19_Garra_Base_Suporte_Fixo
24_Suporte_Encaixe_Servo_Garra
27_Guia_Articulacao_Garra
06_Antebraco_Esquerdo
20_Garra_Dedo_Movel_Direito
21_Garra_Dedo_Movel_Esquerdo
03_Tirante_Paralelogramo_Longo
haste_articulacao_olhal_v4
13_Tirante_Superior_Garra
04_Tirante_Paralelogramo_Medio
28_Biela_Articulacao_Curta
haste_articulacao_curta
05_Haste_Acionamento_Servo_Braco
