Gabriel-Freitas-S/braco-robortico/impressao/pratos/Prato_1_Chassi_Estrutura_Bambu_A1.3mf

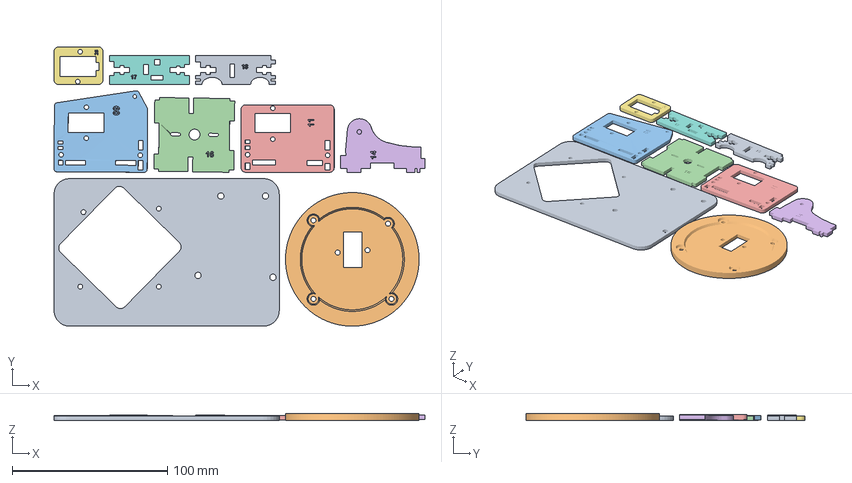
[picture p43: CAD file, 2026-11-13]
impressao/pratos/Prato_1_Chassi_Estrutura_Bambu_A1.3mf
238.8 x 179.8 x 4.70 mm
01_Base_Chassi_Inferior
12_Mesa_Giratoria_Turntable
09_Torre_Suporte_Servo_Direita
16_Berco_Servo_Rotacao_Base
11_Torre_Suporte_Servo_Esquerda
14_Separador_Espacador_Central_Base
25_Trava_Horn_Servo_Base
17_Travessa_Reforco_Base_Frontal
18_Travessa_Reforco_Base_Traseira
