Gabriel-Freitas-S/braco-robortico/montagens/braco_montado_numerado.stl

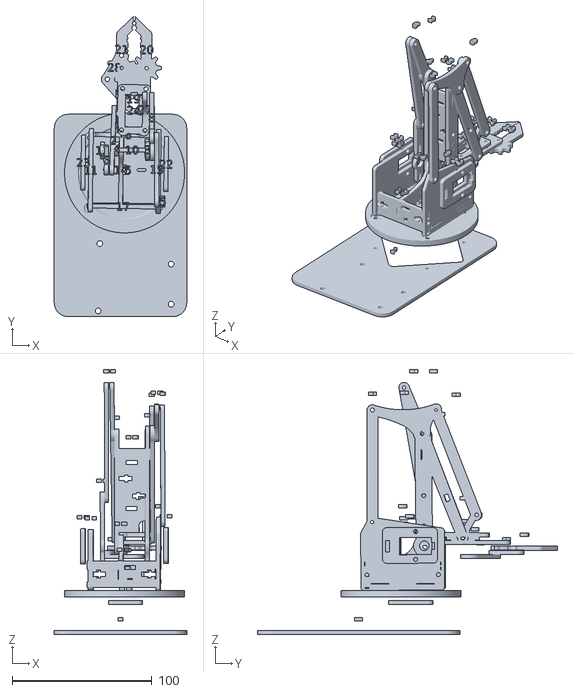
[picture p44: CAD file, 2026-11-13]
montagens/braco_montado_numerado.stl
95.0 x 215.1 x 189.9
