Gabriel-Freitas-S/braco-robortico/ref/mdf/mdf_base_plate.stl

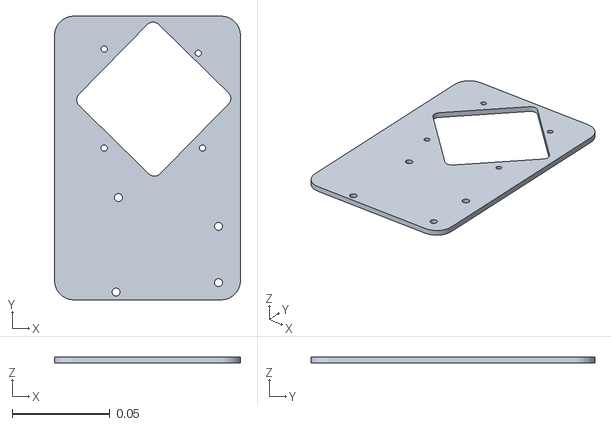
[picture p45: CAD file, 2026-09-27]
ref/mdf/mdf_base_plate.stl
0.095 x 0.145 x 0.003
