Gabriel-Freitas-S/braco-robortico/cad-output/haste_articulacao_curta.step

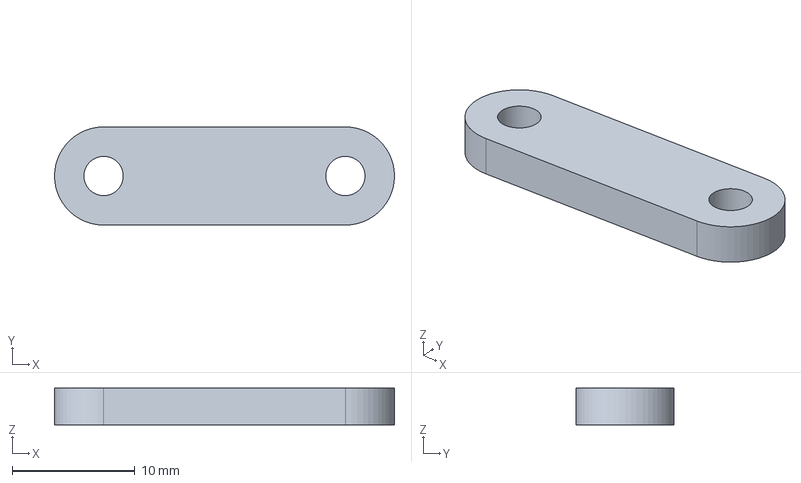
[picture p46: CAD file, 2026-11-07]
cad-output/haste_articulacao_curta.step
27.7 x 8.00 x 3.00 mm
