Gabriel-Freitas-S/braco-robortico/impressao/pecas/haste_articulacao_olhal_v4.stl

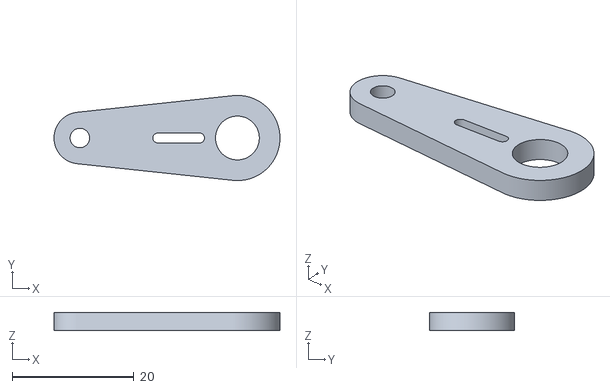
[picture p47: CAD file, 2026-11-13]
impressao/pecas/haste_articulacao_olhal_v4.stl
37.2 x 14.0 x 3.00
