Gabriel-Freitas-S/braco-robortico/cad-output/haste_articulacao_olhal.step

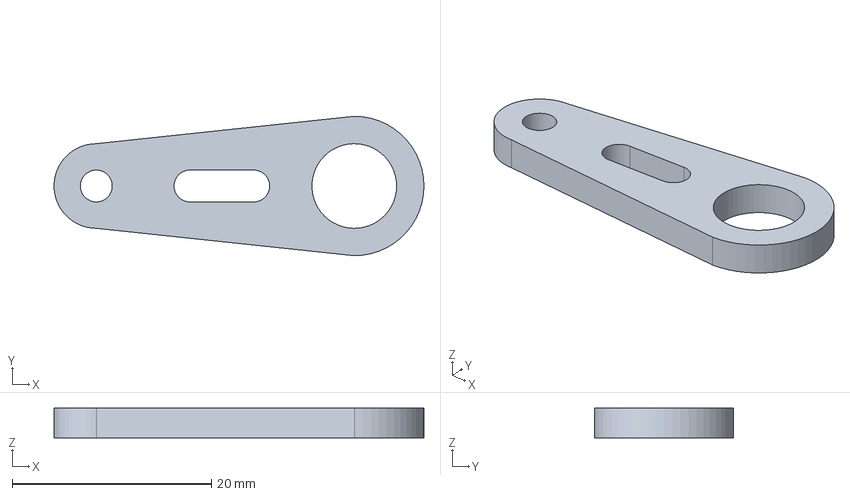
[picture p48: CAD file, 2026-11-07]
cad-output/haste_articulacao_olhal.step
37.1 x 14.0 x 3.00 mm
