Gabriel-Freitas-S/braco-robortico/cad-output/26_Engrenagem_Acionadora_Garra.step

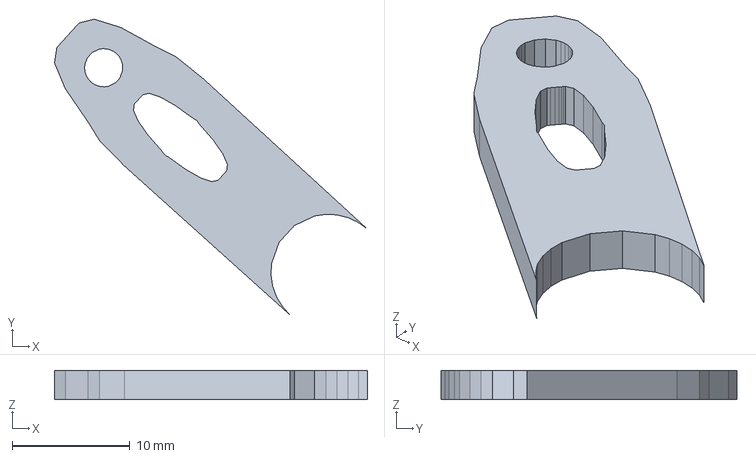
[picture p49: CAD file, 2026-09-27]
cad-output/26_Engrenagem_Acionadora_Garra.step
26.6 x 25.1 x 2.50 mm
