Gabriel-Freitas-S/braco-robortico/cad-output/01_Base_Chassi_Inferior.step

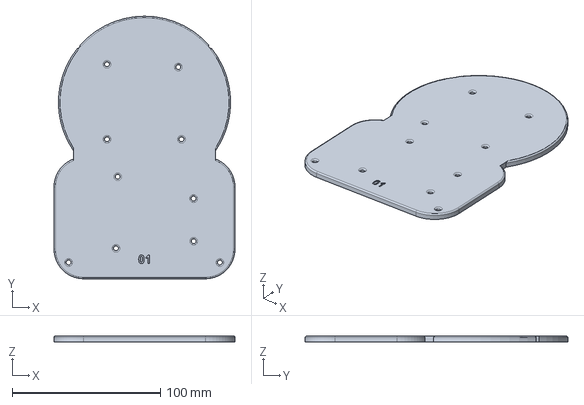
[picture p50: CAD file, 2026-09-27]
cad-output/01_Base_Chassi_Inferior.step
122.0 x 177.1 x 4.00 mm
