Gabriel-Freitas-S/braco-robortico/impressao/pecas/03_Tirante_Paralelogramo_Longo.stl

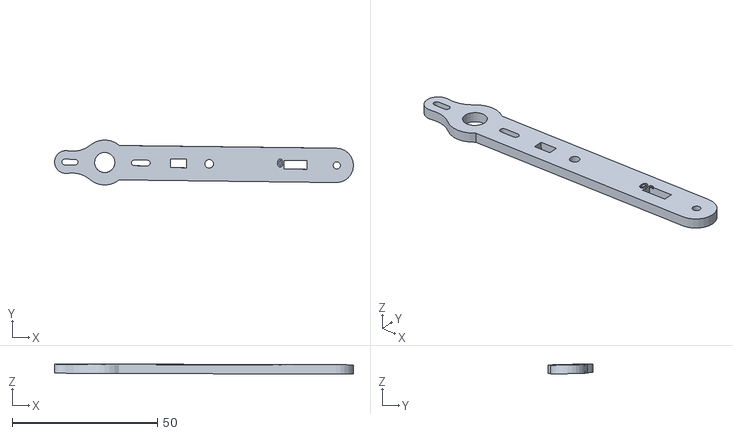
[picture p51: CAD file, 2026-09-27]
impressao/pecas/03_Tirante_Paralelogramo_Longo.stl
103.0 x 15.6 x 3.49
