Gabriel-Freitas-S/braco-robortico/impressao/pecas_fatiadas/23_Biela_Conexao_Horn_Esquerdo_sliced.3mf

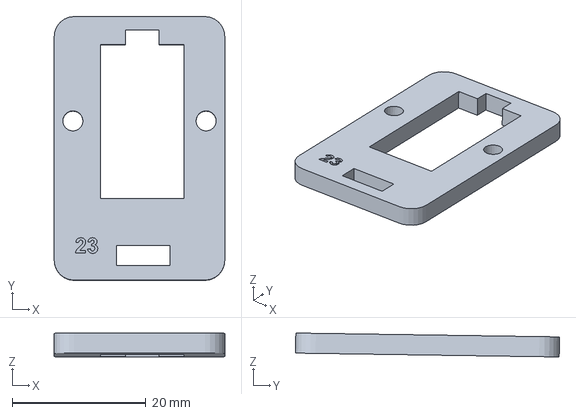
[picture p52: CAD file, 2026-10-03]
impressao/pecas_fatiadas/23_Biela_Conexao_Horn_Esquerdo_sliced.3mf
25.5 x 39.4 x 3.58 mm
