Gabriel-Freitas-S/braco-robortico/cad-output/Shield_Joystick_Duplo.step

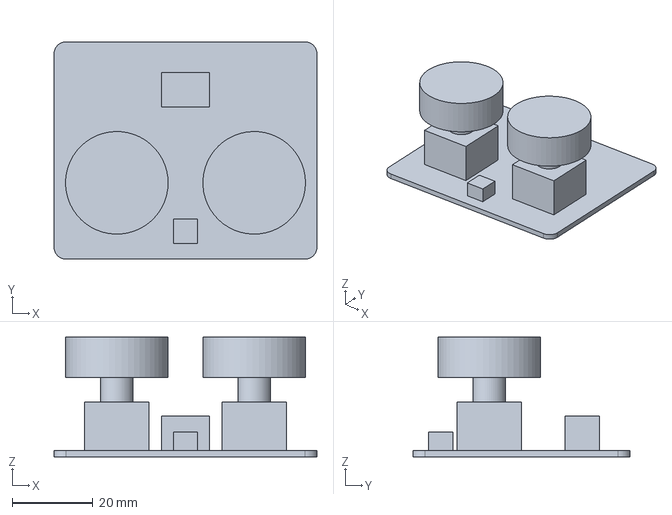
[picture p53: CAD file, 2026-09-27]
cad-output/Shield_Joystick_Duplo.step
65.1 x 53.8 x 29.6 mm
