Gabriel-Freitas-S/braco-robortico/impressao/pecas/07_Braco_Principal_Direito.stl

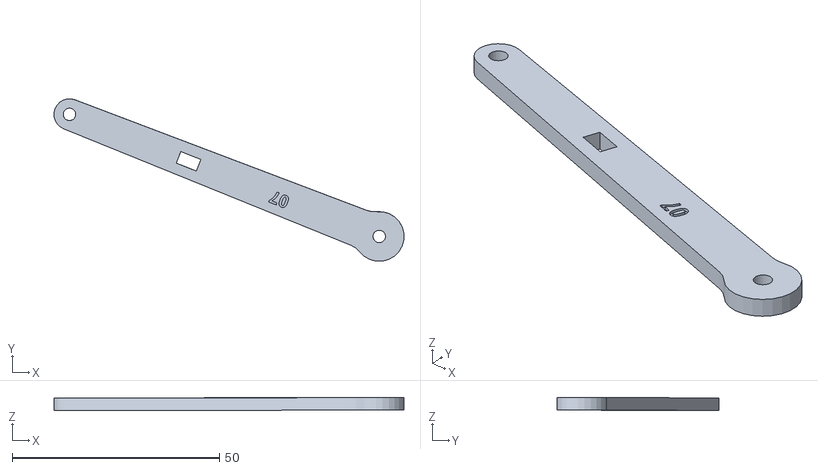
[picture p54: CAD file, 2026-09-27]
impressao/pecas/07_Braco_Principal_Direito.stl
84.4 x 39.1 x 3.16
