Gabriel-Freitas-S/braco-robortico/impressao/pecas_fatiadas/18_Travessa_Reforco_Base_Traseira_sliced.3mf

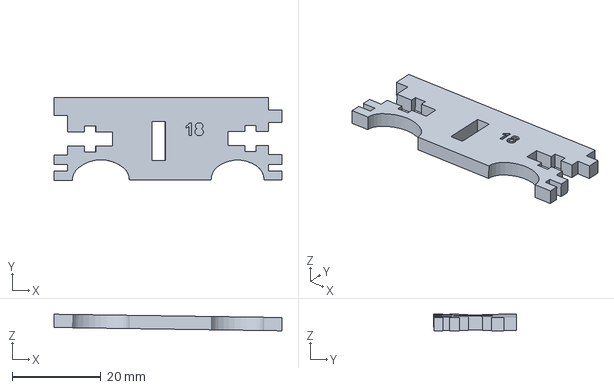
[picture p55: CAD file, 2026-10-03]
impressao/pecas_fatiadas/18_Travessa_Reforco_Base_Traseira_sliced.3mf
51.4 x 18.8 x 3.75 mm
