Gabriel-Freitas-S/braco-robortico/impressao/pecas/19_Garra_Base_Suporte_Fixo.stl

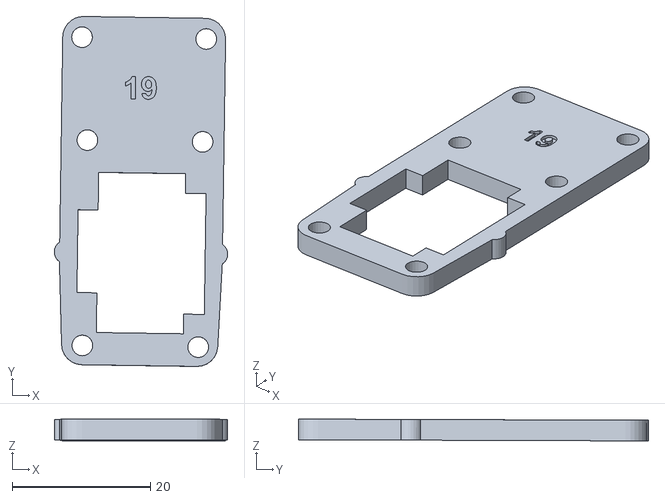
[picture p56: CAD file, 2026-09-27]
impressao/pecas/19_Garra_Base_Suporte_Fixo.stl
25.1 x 50.7 x 3.17
