Gabriel-Freitas-S/braco-robortico/impressao/pecas_fatiadas/25_Trava_Horn_Servo_Base_sliced.3mf

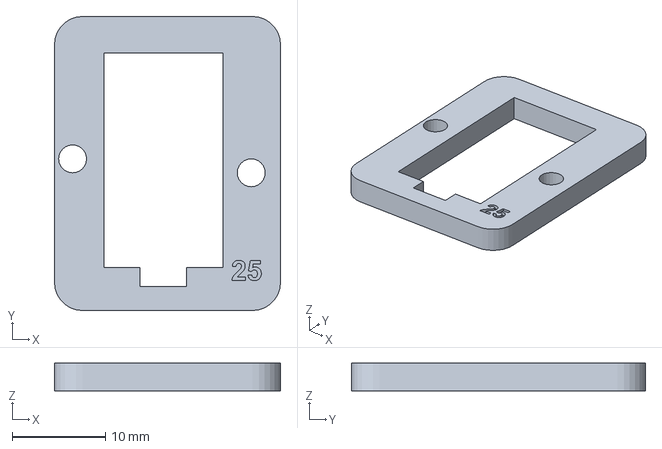
[picture p57: CAD file, 2026-10-03]
impressao/pecas_fatiadas/25_Trava_Horn_Servo_Base_sliced.3mf
24.3 x 31.6 x 3.00 mm
