Gabriel-Freitas-S/braco-robortico/impressao/pecas_fatiadas/14_Separador_Espacador_Central_Base_sliced.3mf

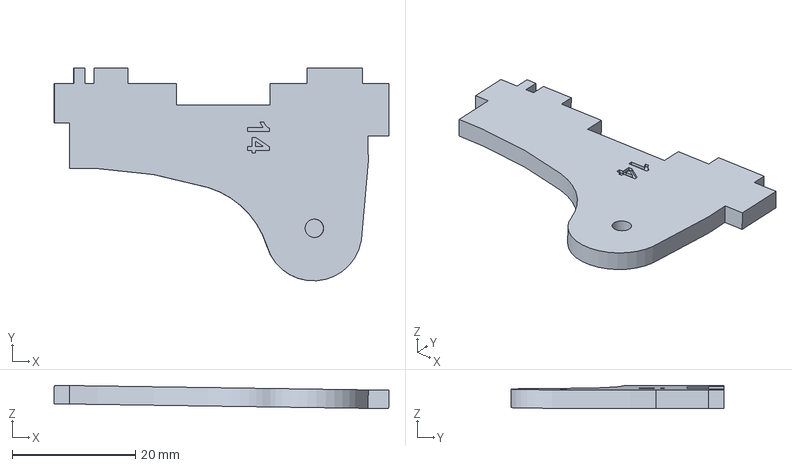
[picture p58: CAD file, 2026-10-03]
impressao/pecas_fatiadas/14_Separador_Espacador_Central_Base_sliced.3mf
54.4 x 34.5 x 3.80 mm
