Gabriel-Freitas-S/braco-robortico/impressao/pecas/02_Braco_Principal_Esquerdo.stl

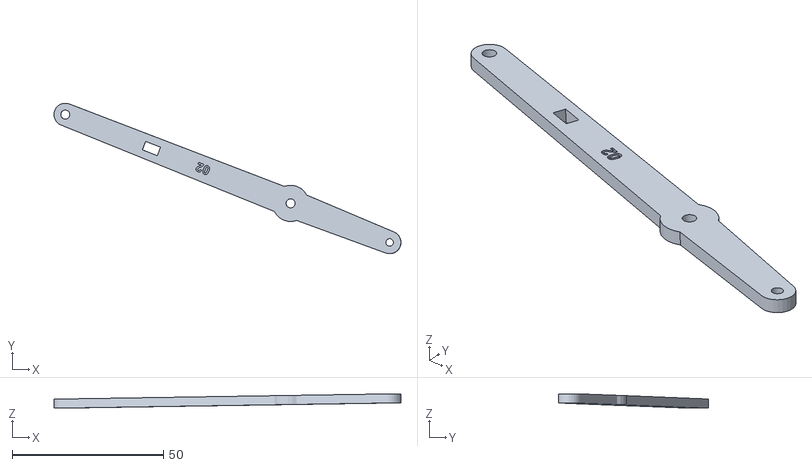
[picture p59: CAD file, 2026-09-27]
impressao/pecas/02_Braco_Principal_Esquerdo.stl
114.8 x 49.8 x 4.79
