Gabriel-Freitas-S/braco-robortico/impressao/pecas_fatiadas/21_Garra_Dedo_Movel_Esquerdo_sliced.3mf

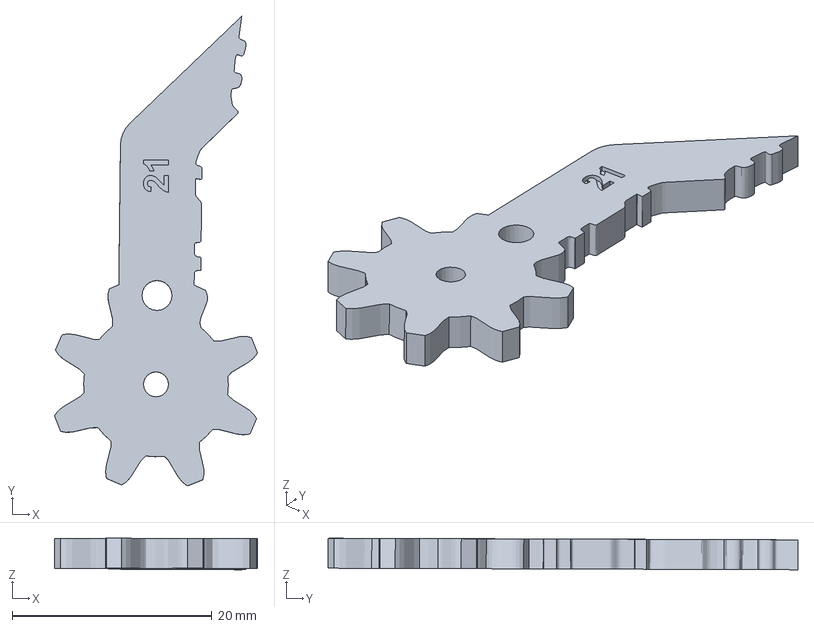
[picture p60: CAD file, 2026-10-03]
impressao/pecas_fatiadas/21_Garra_Dedo_Movel_Esquerdo_sliced.3mf
20.3 x 47.1 x 3.16 mm
