Gabriel-Freitas-S/braco-robortico/impressao/pecas_fatiadas/13_Tirante_Superior_Garra_sliced.3mf

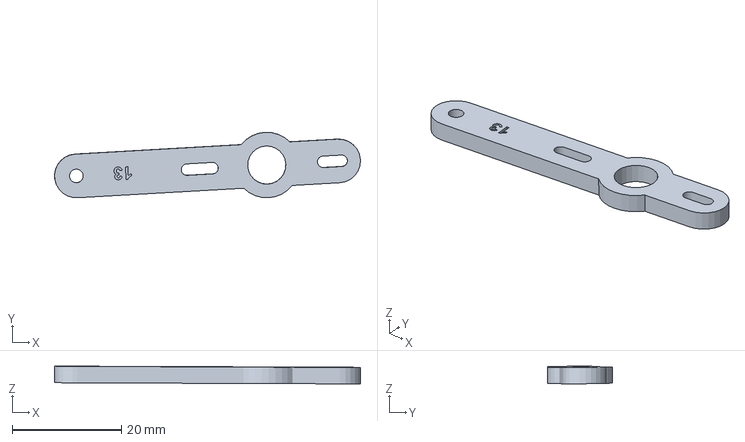
[picture p61: CAD file, 2026-10-03]
impressao/pecas_fatiadas/13_Tirante_Superior_Garra_sliced.3mf
56.1 x 12.0 x 3.25 mm
