Gabriel-Freitas-S/braco-robortico/impressao/pecas/20_Garra_Dedo_Movel_Direito.stl

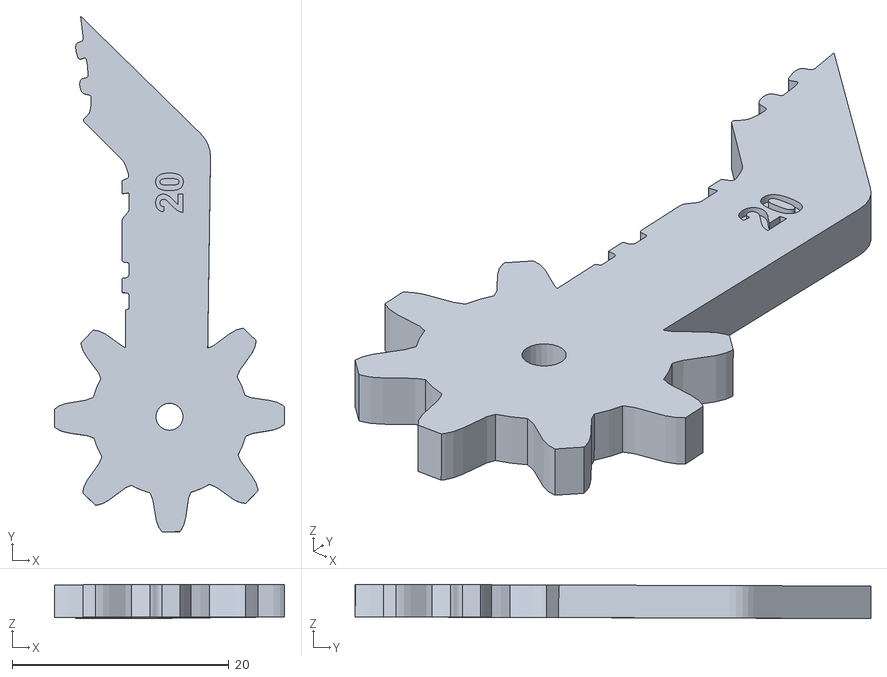
[picture p62: CAD file, 2026-09-27]
impressao/pecas/20_Garra_Dedo_Movel_Direito.stl
21.3 x 47.6 x 3.16
