Gabriel-Freitas-S/braco-robortico/impressao/pecas_fatiadas/20_Garra_Dedo_Movel_Direito_sliced.3mf

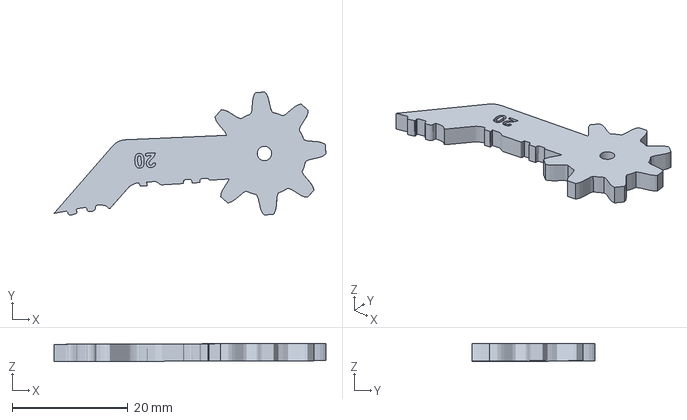
[picture p63: CAD file, 2026-10-03]
impressao/pecas_fatiadas/20_Garra_Dedo_Movel_Direito_sliced.3mf
47.1 x 21.3 x 3.16 mm
