Gabriel-Freitas-S/braco-robortico/impressao/pecas/24_Suporte_Encaixe_Servo_Garra.stl

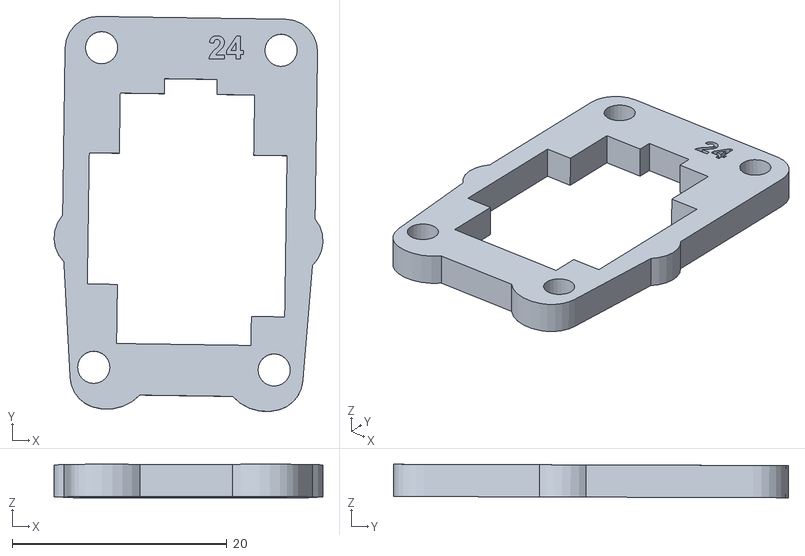
[picture p64: CAD file, 2026-09-27]
impressao/pecas/24_Suporte_Encaixe_Servo_Garra.stl
25.0 x 36.8 x 3.12
