Gabriel-Freitas-S/braco-robortico/impressao/pecas_fatiadas/17_Travessa_Reforco_Base_Frontal_sliced.3mf

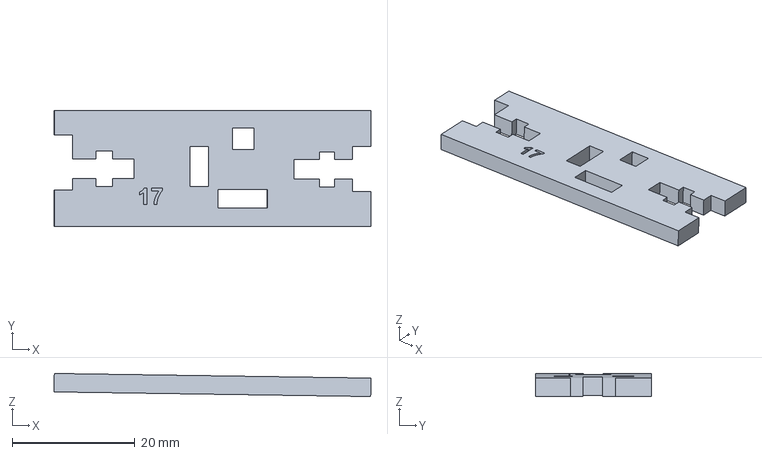
[picture p65: CAD file, 2026-10-03]
impressao/pecas_fatiadas/17_Travessa_Reforco_Base_Frontal_sliced.3mf
51.5 x 18.8 x 3.75 mm
