Gabriel-Freitas-S/braco-robortico/impressao/pecas/11_Torre_Suporte_Servo_Esquerda.stl

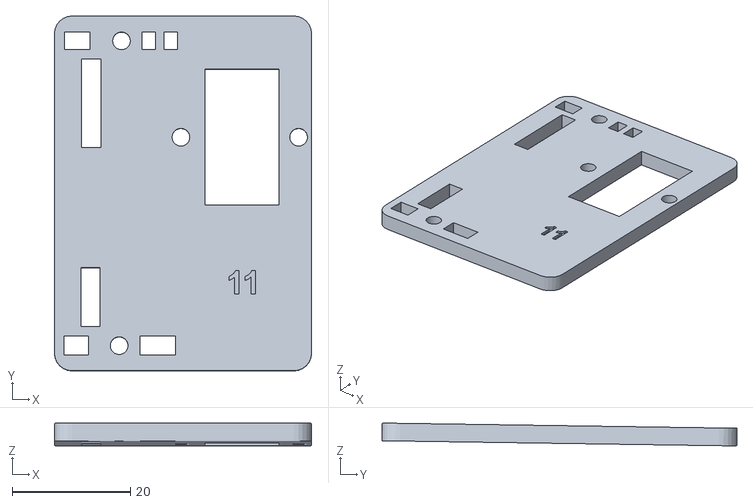
[picture p66: CAD file, 2026-09-27]
impressao/pecas/11_Torre_Suporte_Servo_Esquerda.stl
43.5 x 60.0 x 3.88
