Gabriel-Freitas-S/braco-robortico/impressao/pecas_fatiadas/06_Antebraco_Esquerdo_sliced.3mf

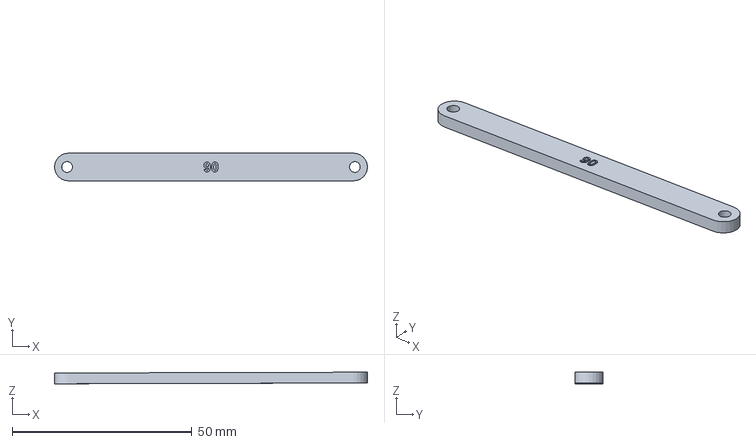
[picture p67: CAD file, 2026-10-03]
impressao/pecas_fatiadas/06_Antebraco_Esquerdo_sliced.3mf
87.0 x 7.71 x 3.24 mm
