Gabriel-Freitas-S/braco-robortico/impressao/pecas/09_Torre_Suporte_Servo_Direita.stl

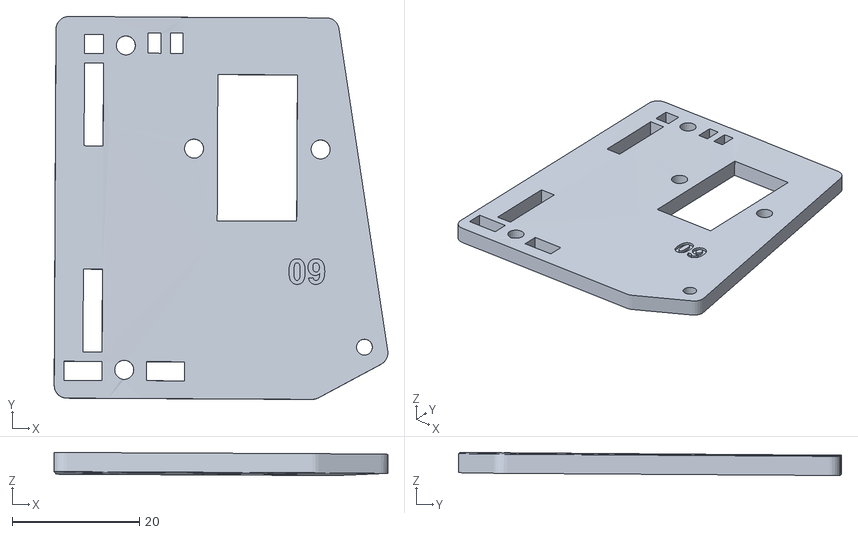
[picture p68: CAD file, 2026-09-27]
impressao/pecas/09_Torre_Suporte_Servo_Direita.stl
52.5 x 60.2 x 3.62
