Gabriel-Freitas-S/braco-robortico/impressao/pecas_fatiadas/28_Biela_Articulacao_Curta_sliced.3mf

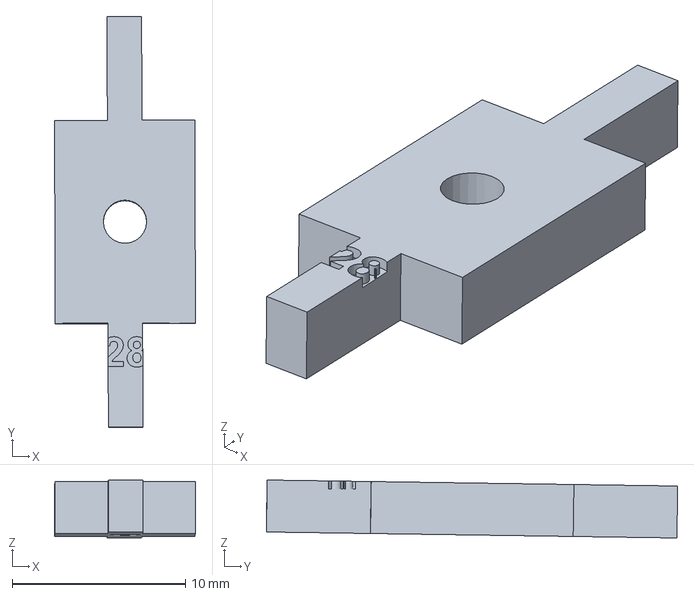
[picture p69: CAD file, 2026-10-03]
impressao/pecas_fatiadas/28_Biela_Articulacao_Curta_sliced.3mf
8.14 x 23.7 x 3.35 mm
