Gabriel-Freitas-S/braco-robortico/impressao/pecas_fatiadas/16_Berco_Servo_Rotacao_Base_sliced.3mf

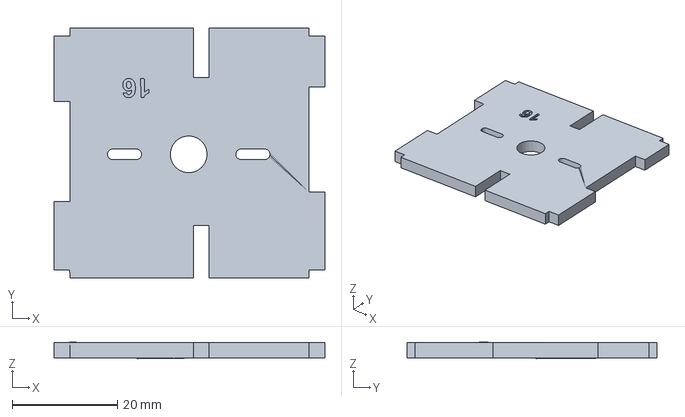
[picture p70: CAD file, 2026-10-03]
impressao/pecas_fatiadas/16_Berco_Servo_Rotacao_Base_sliced.3mf
51.5 x 47.5 x 3.14 mm
