Gabriel-Freitas-S/braco-robortico/impressao/pecas_fatiadas/05_Haste_Acionamento_Servo_Braco_sliced.3mf

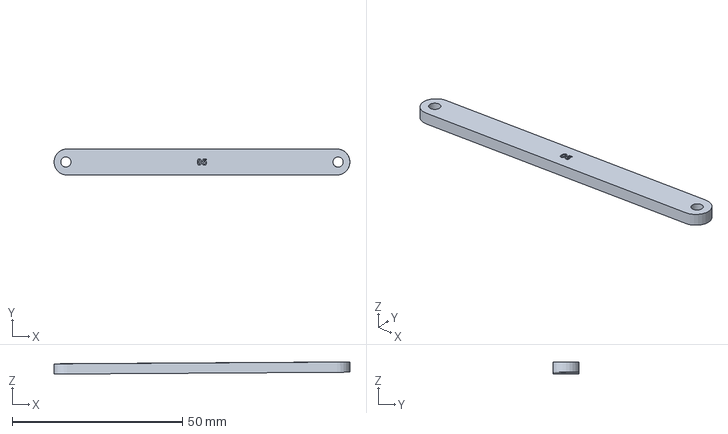
[picture p71: CAD file, 2026-10-03]
impressao/pecas_fatiadas/05_Haste_Acionamento_Servo_Braco_sliced.3mf
87.0 x 7.71 x 3.57 mm
