Gabriel-Freitas-S/braco-robortico/impressao/pecas_fatiadas/01_Base_Chassi_Inferior_sliced.3mf

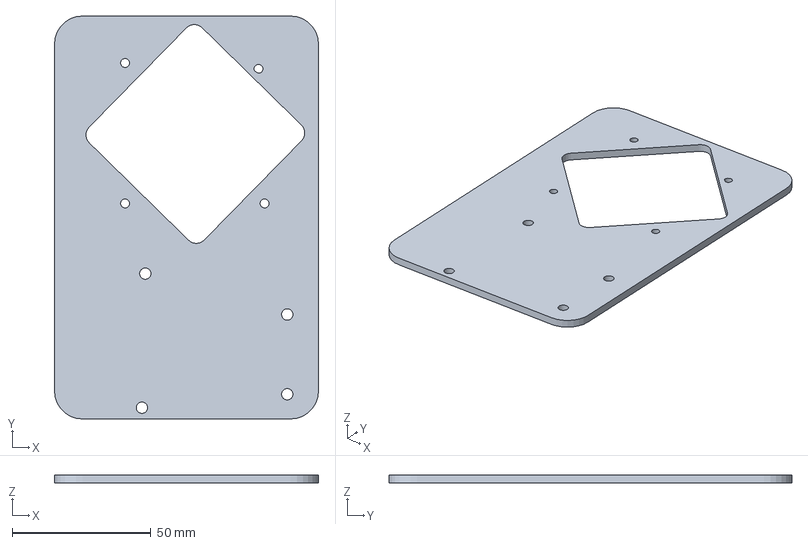
[picture p72: CAD file, 2026-10-03]
impressao/pecas_fatiadas/01_Base_Chassi_Inferior_sliced.3mf
95.0 x 145.0 x 3.00 mm
