Gabriel-Freitas-S/braco-robortico/impressao/pecas_fatiadas/10_Balancim_Triangular_Articulador_sliced.3mf

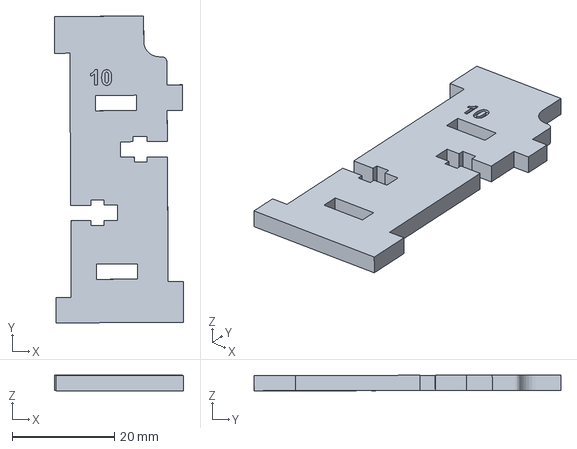
[picture p73: CAD file, 2026-10-03]
impressao/pecas_fatiadas/10_Balancim_Triangular_Articulador_sliced.3mf
25.4 x 60.1 x 3.11 mm
