Gabriel-Freitas-S/braco-robortico/impressao/pecas/08_Antebraco_Direito.stl

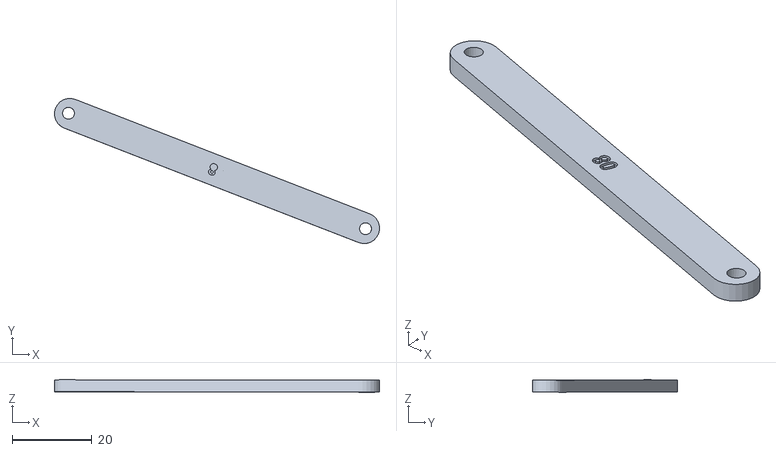
[picture p74: CAD file, 2026-09-27]
impressao/pecas/08_Antebraco_Direito.stl
81.6 x 36.4 x 3.14
