Gabriel-Freitas-S/braco-robortico/impressao/pecas/27_Guia_Articulacao_Garra.stl

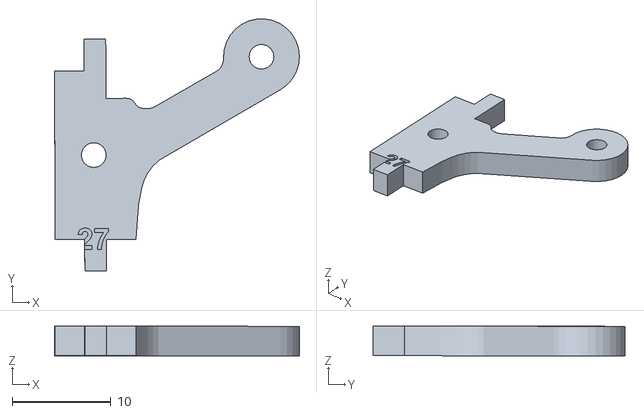
[picture p75: CAD file, 2026-09-27]
impressao/pecas/27_Guia_Articulacao_Garra.stl
24.8 x 25.6 x 3.02
