Gabriel-Freitas-S/braco-robortico/impressao/pecas_fatiadas/08_Antebraco_Direito_sliced.3mf

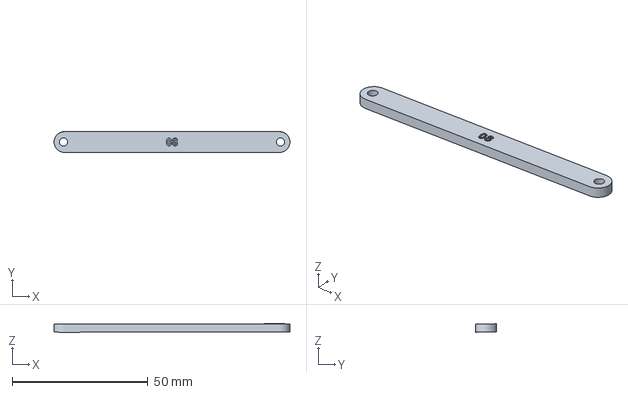
[picture p76: CAD file, 2026-10-03]
impressao/pecas_fatiadas/08_Antebraco_Direito_sliced.3mf
87.0 x 7.73 x 3.14 mm
