Gabriel-Freitas-S/braco-robortico/impressao/pecas_fatiadas/07_Braco_Principal_Direito_sliced.3mf

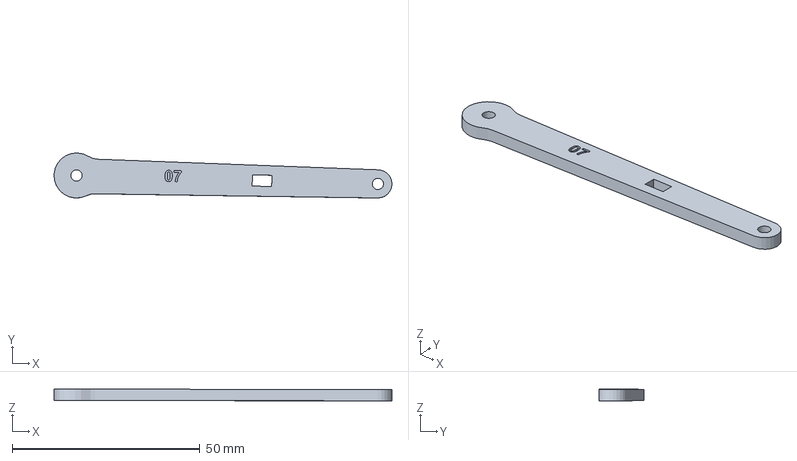
[picture p77: CAD file, 2026-10-03]
impressao/pecas_fatiadas/07_Braco_Principal_Direito_sliced.3mf
90.0 x 12.0 x 3.16 mm
