Gabriel-Freitas-S/braco-robortico/impressao/pecas/15_Suporte_Cabeca_Garra.stl

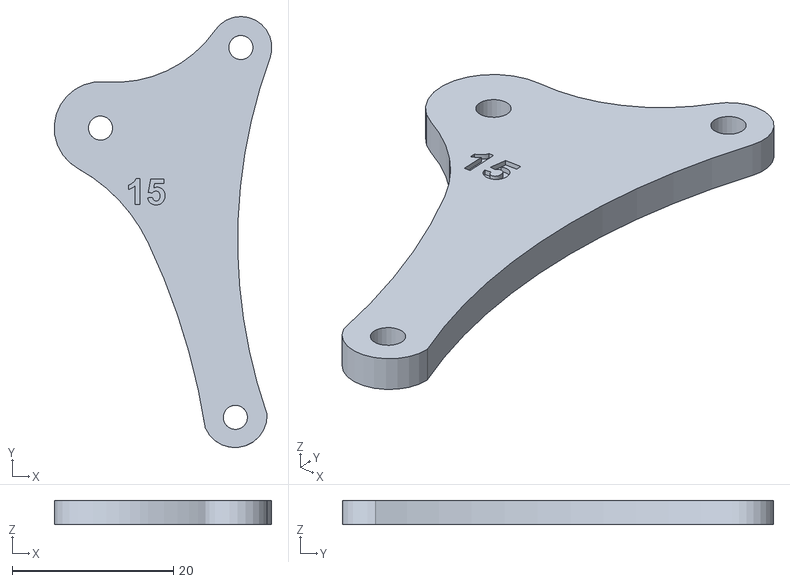
[picture p78: CAD file, 2026-09-27]
impressao/pecas/15_Suporte_Cabeca_Garra.stl
27.0 x 53.5 x 3.03
