Gabriel-Freitas-S/braco-robortico/impressao/pecas_fatiadas/19_Garra_Base_Suporte_Fixo_sliced.3mf

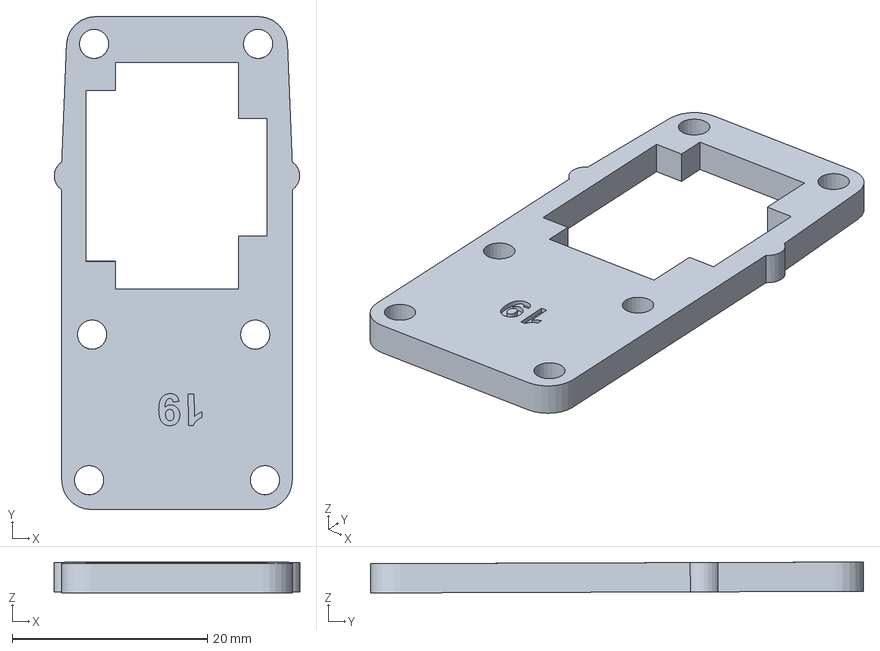
[picture p79: CAD file, 2026-10-03]
impressao/pecas_fatiadas/19_Garra_Base_Suporte_Fixo_sliced.3mf
25.1 x 50.5 x 3.17 mm
