Gabriel-Freitas-S/braco-robortico/impressao/pecas_fatiadas/27_Guia_Articulacao_Garra_sliced.3mf

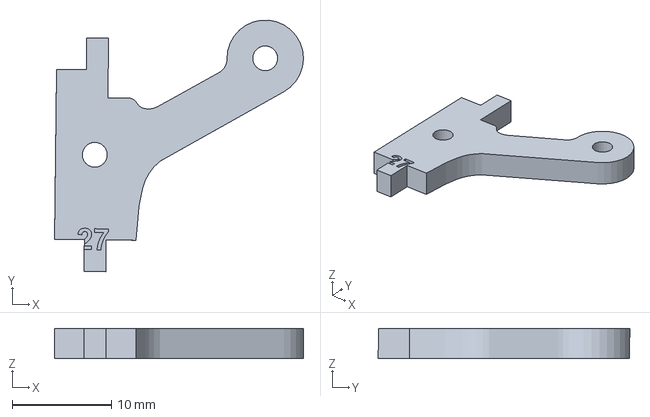
[picture p80: CAD file, 2026-10-03]
impressao/pecas_fatiadas/27_Guia_Articulacao_Garra_sliced.3mf
25.0 x 25.3 x 3.02 mm
