Gabriel-Freitas-S/braco-robortico/impressao/pecas/06_Antebraco_Esquerdo.stl

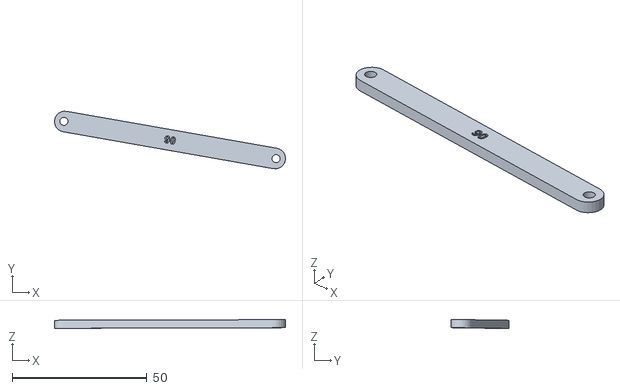
[picture p81: CAD file, 2026-09-27]
impressao/pecas/06_Antebraco_Esquerdo.stl
85.8 x 21.4 x 3.24
