Gabriel-Freitas-S/braco-robortico/impressao/pecas_fatiadas/02_Braco_Principal_Esquerdo_sliced.3mf

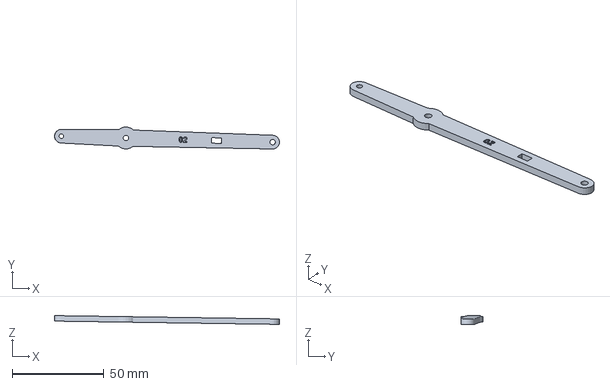
[picture p82: CAD file, 2026-10-03]
impressao/pecas_fatiadas/02_Braco_Principal_Esquerdo_sliced.3mf
122.9 x 12.0 x 4.79 mm
