Gabriel-Freitas-S/braco-robortico/(list of files, cad)

Other CAD files:
impressao/pecas_fatiadas/04_Tirante_Paralelogramo_Medio_sliced.3mf
impressao/pecas_fatiadas/12_Mesa_Giratoria_Turntable_sliced.3mf
impressao/pratos/fatiados/Prato_1_Chassi_Estrutura_Bambu_A1_sliced.3mf
impressao/pratos/Prato_2_Mecanica_Garra_Bambu_A1.3mf
impressao/pecas/haste_articulacao_curta.stl
impressao/pecas_fatiadas/haste_articulacao_curta_sliced.3mf
impressao/pecas/04_Tirante_Paralelogramo_Medio.stl
impressao/pecas_fatiadas/haste_articulacao_olhal_v4_sliced.3mf
impressao/pecas/22_Biela_Conexao_Horn_Direito.stl
impressao/pecas/14_Separador_Espacador_Central_Base.stl
impressao/pecas/18_Travessa_Reforco_Base_Traseira.stl
impressao/pecas/13_Tirante_Superior_Garra.stl
impressao/pecas/23_Biela_Conexao_Horn_Esquerdo.stl
impressao/pecas/05_Haste_Acionamento_Servo_Braco.stl
impressao/pecas_fatiadas/11_Torre_Suporte_Servo_Esquerda_sliced.3mf
impressao/pecas/16_Berco_Servo_Rotacao_Base.stl
impressao/pecas_fatiadas/24_Suporte_Encaixe_Servo_Garra_sliced.3mf
impressao/pecas/28_Biela_Articulacao_Curta.stl
impressao/pecas/25_Trava_Horn_Servo_Base.stl
impressao/pecas_fatiadas/09_Torre_Suporte_Servo_Direita_sliced.3mf
impressao/pecas/21_Garra_Dedo_Movel_Esquerdo.stl
impressao/pecas/10_Balancim_Triangular_Articulador.stl
impressao/pecas_fatiadas/03_Tirante_Paralelogramo_Longo_sliced.3mf
impressao/pecas/17_Travessa_Reforco_Base_Frontal.stl
impressao/pecas_fatiadas/15_Suporte_Cabeca_Garra_sliced.3mf
impressao/pecas_fatiadas/22_Biela_Conexao_Horn_Direito_sliced.3mf
impressao/pecas/01_Base_Chassi_Inferior.stl
cad-output/01_Base_Chassi_Inferior.stl
cad-output/04_Tirante_Paralelogramo_Medio.stl
cad-output/Shield_Joystick_Duplo.stl
cad-output/haste_articulacao_olhal.stl
