Gabriel-Freitas-S/braco-robortico/docs/assets/parts/test_flat_stl.png

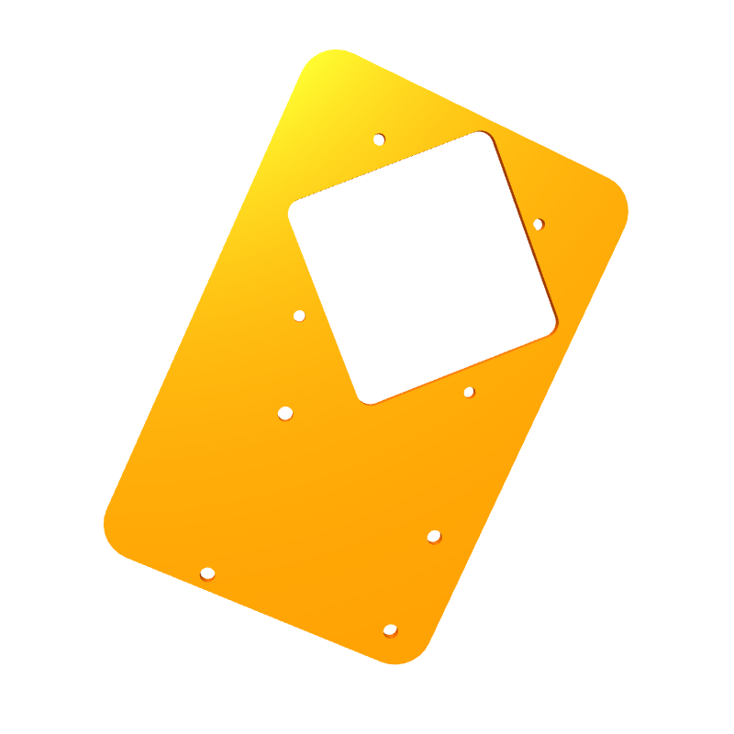
docs/assets/parts/test_flat_stl.png
