Gabriel-Freitas-S/braco-robortico/docs/assets/parts/test_mpl.png

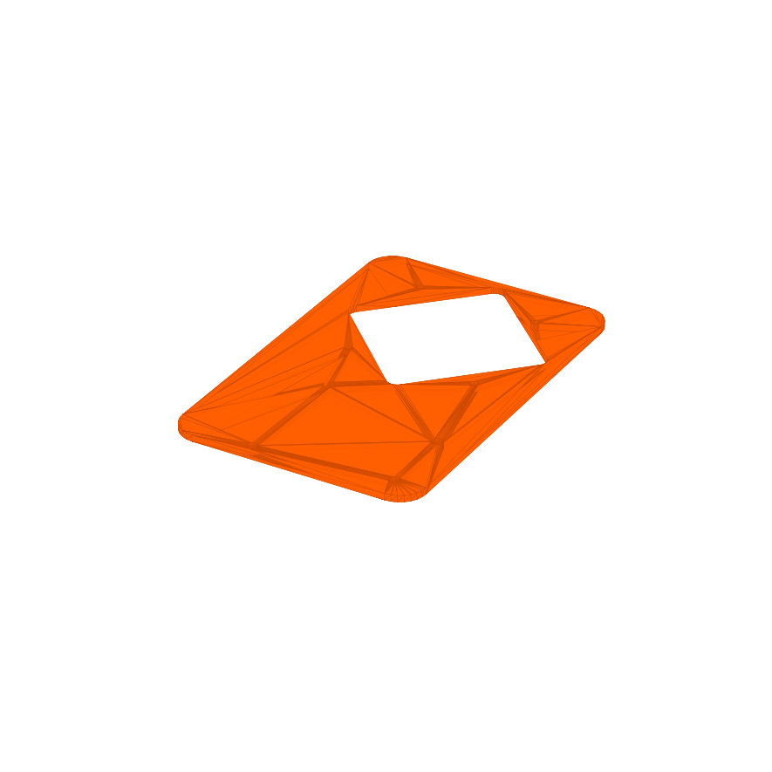
docs/assets/parts/test_mpl.png
