Gabriel-Freitas-S/braco-robortico/docs/assets/parts/test_threejs.png

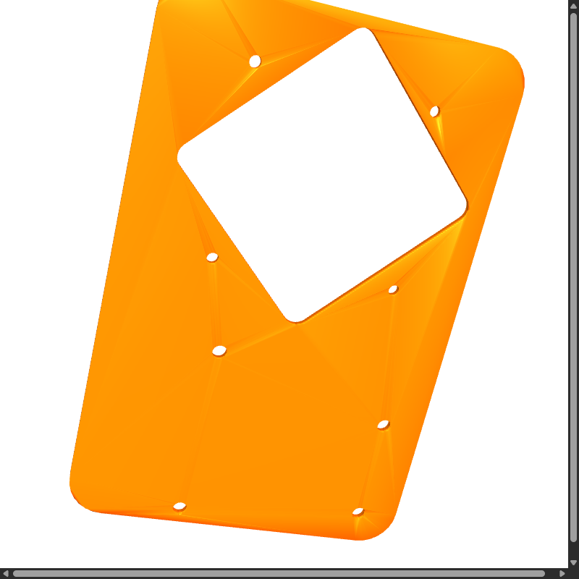
docs/assets/parts/test_threejs.png
