Gabriel-Freitas-S/braco-robortico/(commit log)

2026-09-27 feat: add CAD-to-print agent workflow, 3D printing plates, and updated manual assets
    [Prato_1_Chassi_Estrutura_Bambu_A1.3mf, Prato_2_Mecanica_Garra_Bambu_A1.3mf]
2026-09-27 feat: add 3D rendering automation scripts, CAD outputs, and updated assembly documentation assets
    [01_Base_Chassi_Inferior.step, 01_Base_Chassi_Inferior.stl, Prato_1_Chassi_Estrutura_Bambu_A1.3mf, Shield_Joystick_Duplo.step, Shield_Joystick_Duplo.stl, braco_completo_com_componentes.stl, test_p02_debossed.stl, test_p28_debossed.stl]
2026-09-27 feat: debossed numbers on all 28 STLs + organized sliced files + updated manual estimates
    [01_Base_Chassi_Inferior.stl, 01_Base_Chassi_Inferior_sliced.3mf, 02_Braco_Principal_Esquerdo.stl, 02_Braco_Principal_Esquerdo_sliced.3mf, 03_Tirante_Paralelogramo_Longo.stl, 03_Tirante_Paralelogramo_Longo_sliced.3mf, 04_Tirante_Paralelogramo_Medio.stl, 04_Tirante_Paralelogramo_Medio_sliced.3mf]
2026-09-27 chore: update codebase files
    [Prato_1_Chassi_Estrutura_Bambu_A1.3mf, Prato_2_Mecanica_Garra_Bambu_A1.3mf]
2026-09-27 docs: update all 28 part print times and weights in manual with real Bambu Studio estimates
2026-09-27 feat: add 3D printed plates, part renders, manual assets, and build scripts
    [Prato_1_Chassi_Estrutura_Bambu_A1.3mf, Prato_1_Chassi_Estrutura_Bambu_A1_sliced.3mf, Prato_2_Mecanica_Garra_Bambu_A1.3mf, Prato_2_Mecanica_Garra_Bambu_A1_sliced.3mf, braco_completo_com_componentes.stl]
2026-09-27 feat: add CAD fix scripts, generated render assets, and update component metadata
    [04_Tirante_Paralelogramo_Medio.stl, 04_Tirante_Paralelogramo_Medio_corrigido.step, 04_Tirante_Paralelogramo_Medio_corrigido.stl, 26_Engrenagem_Acionadora_Garra.step, 26_Engrenagem_Acionadora_Garra.stl, Prato_1_Chassi_Estrutura_Bambu_A1.3mf, Prato_1_Chassi_Estrutura_Bambu_A1_sliced.3mf, Prato_2_Mecanica_Garra_Bambu_A1.3mf]
2026-09-27 feat: add complete dual joystick arm build script with updated 3D models and renders
    [01_Base_Chassi_Inferior.stl, braco_completo_com_componentes.stl]
2026-10-03 feat: add 3D printed parts, firmware, PDF assets, and project documentation for robotic arm
    [01_Base_Chassi_Inferior_sliced.3mf, 02_Braco_Principal_Esquerdo_sliced.3mf, 03_Tirante_Paralelogramo_Longo_sliced.3mf, 04_Tirante_Paralelogramo_Medio_sliced.3mf, 05_Haste_Acionamento_Servo_Braco_sliced.3mf, 06_Antebraco_Esquerdo_sliced.3mf, 07_Braco_Principal_Direito_sliced.3mf, 08_Antebraco_Direito_sliced.3mf]
2026-10-06 feat: add firmware and Wokwi simulation sketch for 4-DOF robotic arm
2026-11-07 feat: pecas 04 corrigidas, hastes de articulacao, firmware braco_novo e artefatos de impressao
    [04_Tirante_Paralelogramo_Medio_corrigido.stl, 04_Tirante_Paralelogramo_Medio_encaixe10.step, 04_Tirante_Paralelogramo_Medio_encaixe10.stl, 04_Tirante_Paralelogramo_Medio_pivo7.step, 04_Tirante_Paralelogramo_Medio_pivo7.stl, 04_Tirante_Paralelogramo_Medio_pivo7_slot.step, 04_Tirante_Paralelogramo_Medio_pivo7_slot.stl, 04_Tirante_Paralelogramo_Medio_slot.step]
2026-11-07 fix(firmware): inverter eixos do joystick direito na Shield PD07, reter torque na garra e suavizar partida
    - Mapeia A3 (esquerda/direita do joystick direito) para a Garra (esquerda=fecha, direita=abre) e A2 (cima/baixo) para o Ombro.
    - Mantem os servos conectados com pulso continuo em microssegundos apos o primeiro movimento para segurar objetos na garra e evitar trancos de religamento.
    - Reduz zona morta para 25 com media de 4 leituras ADC e curva quadratica (0.18 linear + 0.82 quadratica) para resposta imediata e precisa sem arranque brusco.
    - Remove D2, D3 e D4 de escreveBase() para nao conflitar com botoes e LED da Shield Casa da Robotica PD07.
    [braco_4dof.ino, sketch.ino]
2026-11-07 fix(firmware): inverter sentido da base, evitar queda termica no alto e remover delay do joystick
    - Inverte sentido da Base (-GANHO_BASE) no joystick esquerdo (A0).
    - Evita que o regulador 5V do Arduino desarme no alto com fonte 12V: desliga Base/Ombro/Cotovelo apos 240 ms parados, mantem Garra ativa quando fechada (<32 graus) e protege angulos em memoria .noinit contra resets de tensao.
    - Remove o delay de resposta do joystick reduzindo JOY_DEADZONE para 18 e aumentando FATOR_SUAVIZACAO para 0.45 com curva 50/50.
    [braco_4dof.ino, sketch.ino]
2026-11-07 fix(firmware): reduzir velocidade maxima e aumentar precisao fina no cotovelo mantendo zero delay
    - Reduz GANHO_COTOVEL de 1.55 para 0.50 (~25 graus/s max), GANHO_OMBRO para 0.65 (~32 graus/s) e GANHO_BASE/GARRA para 0.75 (~37 graus/s).
    - Ajusta VEL_SUAVE para 0.038 e curva para 25% linear + 75% quadratica mantendo FATOR_SUAVIZACAO=0.50 (resposta instantanea ao tocar no joystick, porem com deslocamento lento e preciso).
    [braco_4dof.ino, sketch.ino]
2026-11-07 feat(firmware): botao do joystick retorna suavemente para a posicao 0 uma junta por vez
    - Configura os botoes dos joysticks da Shield PD07 (D2 e D4 com INPUT_PULLUP) com debounce.
    - Ao pressionar qualquer um dos dois botoes, aciona o retorno sequencial para a posicao 0/inicial (Ombro -> Cotovelo -> Base -> Garra em 0 graus), movendo uma junta por vez para nao sobrecarregar a fonte 12V.
    - Movimentar qualquer joystick durante o retorno cancela o modo automatico e devolve o controle manual na hora.
2026-11-07 feat(firmware): liberar curso completo 0-180 graus (480-2500us) e gravar Posicao 0 na EEPROM segurando o botao
    - Libera limites de Base, Ombro e Cotovelo para 0..180 graus e pulsos 480..2500 us para permitir descida completa do braco.
    - Ajusta Posicao 0 padrao inicial (Ombro=60, Cotovelo=45) e adiciona gravacao permanente na EEPROM ao segurar o botao do joystick por 1.8s (1 clique curto vai para a Posicao 0 salva).
2026-11-07 fix(firmware): restaurar pulso SG90 (544..2400us) e curso/ganho da garra
    - Restaura US_MIN=544.0 e US_MAX=2400.0 para evitar pulsos fora da faixa do SG90 na garra (D6).\n- Ajusta posZeroGarra=35.0, limGarraMin=10.0, limGarraMax=150.0 e GANHO_GARRA=1.35.\n- Reduz limiar de ativacao de movimento no loop() para 0.005.
    [braco_4dof.ino, sketch.ino]
2026-11-07 fix(firmware): limitar garra em 10..90 graus e evitar stall continuo no batente
    - Restringe limGarraMax para 90.0 graus (faixa fisica das engrenagens 20/21/26) para nao passar do fim de curso.\n- Evita stall infinito em 10 graus limitando o hold da garra a 15s na faixa 12..38 graus e adiciona pulso inicial de destravamento em 35 graus.
    [braco_4dof.ino, sketch.ino]
2026-11-12 fix(firmware): isolar eixo dominante no movimento lateral, manter sustentacao do braco e pressao continua na garra (0..90)
    [braco_4dof.ino, sketch.ino]
2026-11-12 feat(firmware): separa botoes dos joysticks (D2=Pos 0, D4=Trava de pressao da garra) (v1.2.5)
2026-11-12 fix(firmware): protecao anti-batida da base no parafuso e calibracao de limites na EEPROM (v1.2.6)
    [braco_4dof.ino, sketch.ino]
2026-11-12 fix(firmware): trava exclusiva de eixo (modo cruz +) no joystick para separar lado/lado de cima/baixo (v1.2.7)
    [braco_4dof.ino, sketch.ino]
2026-11-12 fix(firmware): base responde a qualquer desvio lateral e ombro/cotovelo mantem torque durante o giro (v1.2.8)
    [braco_4dof.ino, sketch.ino]
2026-11-12 feat(firmware): comando 'x' troca os dois joysticks em tempo real para testar modulo com defeito
2026-11-12 revert(firmware): remove troca de joysticks; add teste 'b' que identifica o pino fisico da base
    [braco_4dof.ino, sketch.ino]
2026-11-12 feat(firmware): teste 'b' pisca a base N vezes para identificar o pino pelo numero de piscadas
2026-11-12 fix(firmware): base no D6 e garra no D11 (pinos estavam trocados; servo da base identificado pelo teste b)
    [braco_4dof.ino, sketch.ino]
2026-11-12 fix(firmware): base volta ao D11 e garra confirmada no D6
    [braco_4dof.ino, sketch.ino]
2026-11-12 fix(firmware): garra no D5 e remove D5 do espelho do cotovelo
    [braco_4dof.ino, sketch.ino]
2026-11-13 fix(firmware): histerese na zona morta e hold de 600ms na base (elimina trancos no giro)
    [braco_4dof.ino, sketch.ino]
2026-11-13 feat(firmware): imprime FW_VER na serial (v1.2.12) para provar qual binario esta gravado
2026-11-13 fix(firmware): curva de resposta 70/30 e centros calibrados no comando s (v1.2.13)
    [braco_4dof.ino, sketch.ino]
2026-11-13 feat: firmware v1.3.0 com protocolo USB (#P/#M/#J/#H/#S/#B) e app egui de controle e gravacao
2026-11-13 feat: firmware v1.3.1 com sticks virtuais (#V) e UI de toque com dois pads no lugar dos sliders
2026-11-13 feat: trava de pressao da garra no app (#L0/#L1) e no status; firmware v1.3.2
2026-11-13 fix(app): layout para tela de toque larga - botoes 36px, pads centralizados na altura toda, log recolhivel, falso positivo do contador de boots
    [main.rs]
2026-11-13 fix(app): centraliza os pads dentro do layout horizontal (add_space no vertical jogava os pads para fora da tela)
    [main.rs]
2026-11-13 feat(app): instalacao no perfil do usuario (binario, icone, entrada de menu) e movimentos em ~/.local/share/robocontrol
2026-11-13 style(app): tema escuro proprio, secoes, chips de leitura, status em pill e pads com estado ativo
2026-11-13 feat(app): excluir movimento com confirmacao inline; painel de replay fixo embaixo (lista nao corta mais o Reproduzir)
    [main.rs, motion.rs]
2026-11-13 fix(app): limita a largura do painel de gravacao e trunca rotulos longos (painel crescia e engolia a tela quando havia movimento salvo)
    [main.rs]
2026-11-13 feat(app): icones vetoriais desenhados (play/stop/cadeado/raio/monitor/joystick/x) e fim da sobreposicao do bloco de replay na lista
2026-11-13 fix(app): painel de gravacao inteiro rolavel (scroll aparece quando precisa) e replay sempre visivel
    [main.rs]
2026-11-13 docs(app): dica do STOP explica o que ele faz e que os servos desenergizam depois de ~0,6s
2026-11-13 feat(app): install.sh cria atalho na area de trabalho (respeita xdg-user-dir e marca como confiavel)
2026-11-13 feat: revisão nov/2026 — peças H1/H2, manual Rev23 e site do projeto
    - peça 26 removida; 04 com encaixe de 10 mm; 12 Turret V7 Redonda
    - hastes H1/H2 como peças do conjunto (29 peças)
    - montagem numerada, pratos e fatiados refeitos
    - manual atualizado (17 páginas) e PDF Rev23
    - página para GitHub Pages com preview do RoboControl
    - README e créditos do modelo de referência (Robótica Paraná, CC BY 4.0)
    [01_Base_Chassi_Inferior.stl, 01_Base_Chassi_Inferior_sliced.3mf, 02_Braco_Principal_Esquerdo.stl, 02_Braco_Principal_Esquerdo_sliced.3mf, 03_Tirante_Paralelogramo_Longo.stl, 03_Tirante_Paralelogramo_Longo_sliced.3mf, 04_Tirante_Paralelogramo_Medio.step, 04_Tirante_Paralelogramo_Medio.stl]
2026-11-13 fix(app): portas COM/cu e diretório de dados no Windows
    - filtro de portas por sistema: COM no Windows, usbmodem/wchusbserial no macOS
    - movimentos em %APPDATA%\robocontrol\movimentos no Windows
    - Linux/macOS continuam em ~/.local/share/robocontrol/movimentos
    [main.rs]
2026-11-13 feat(app): layout touch responsivo e documentação rustdoc
    - pads lado a lado/empilhados com breakpoints (1024/760/380) e alvo de 48 pt
    - docs de módulo e de item nos 5 arquivos: invariantes do protocolo, threading da serial, formato JSON e convenções dos ícones
    - rustdoc navegável gerado em docs/rust (GitHub Pages)
2026-11-13 docs: requisitos multiplataforma e link do rustdoc no site
    - README com dependências por SO, porta típica e diretório de movimentos
    - página do projeto com tabela de portas/caminhos e requisitos
2026-11-13 docs(firmware): corrige comentários desatualizados e documenta EEPROM/holds
    - pinagem/repouso reais, comandos existentes e baud 115200
    - aritmética de anguloParaUs e ganho efetivo da garra (57°/s)
    - limiares reais dos eixos, mapa da EEPROM e tempos de hold
    - status manual prefixado [status] para não colidir com o diagnóstico do app
    [braco_4dof.ino]
2026-11-13 fix(site): formata o bloco de requisitos (grid e tabela)
2026-11-13 docs(app): requisitos e instruções para macOS e Windows
2026-11-13 docs(site): comandos de execução compatíveis com PowerShell
